RileyLeff/sapflux_sensor/releases/sap-flux-adapter-v0.1-layout-safety-2026-06-22/README.md

# Sap Flux Adapter v0.1 Layout Safety Copy

Created 2026-06-22 before hydrating the active KiCad layout for v0.2 input
protection work.

Files:

- `default.shipped-v0.1.kicad_pcb`: exact copy of the archived JLC-shipped
  PCB layout from `../sap-flux-adapter-v1.1-shipped-2026-03-21/default.kicad_pcb`.
  This is the canonical shipped board layout, despite the archive directory
  using the v1.1 release name; the board artwork itself is labeled v0.1.
- `default.active-pre-v0.2-hydration.kicad_pcb`: copy of
  `../../elec/layouts/default/default.kicad_pcb` immediately before replacing
  it with the Atopile-generated v0.2 layout.

Do not edit these files in place. Use them as recovery/reference artifacts.
