RileyLeff/sapflux_sensor/analysis/compression_research_20261024/fig_noise.png

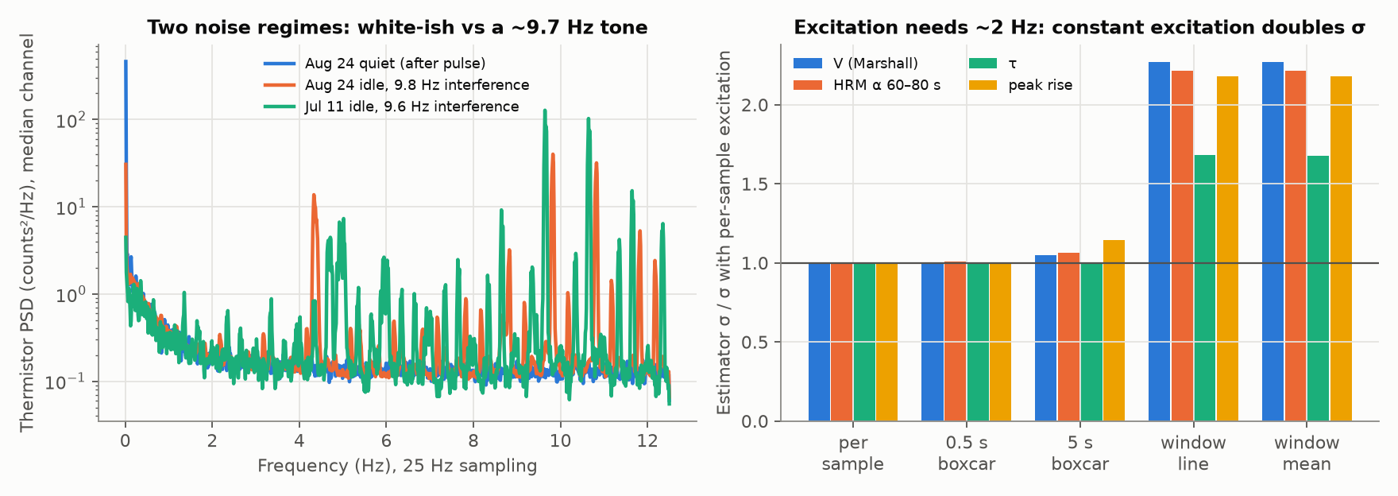
analysis/compression_research_20261024/fig_noise.png
