RileyLeff/sapflux_sensor/analysis/flow_vector_research_20261024/fig_fisher_angle.png

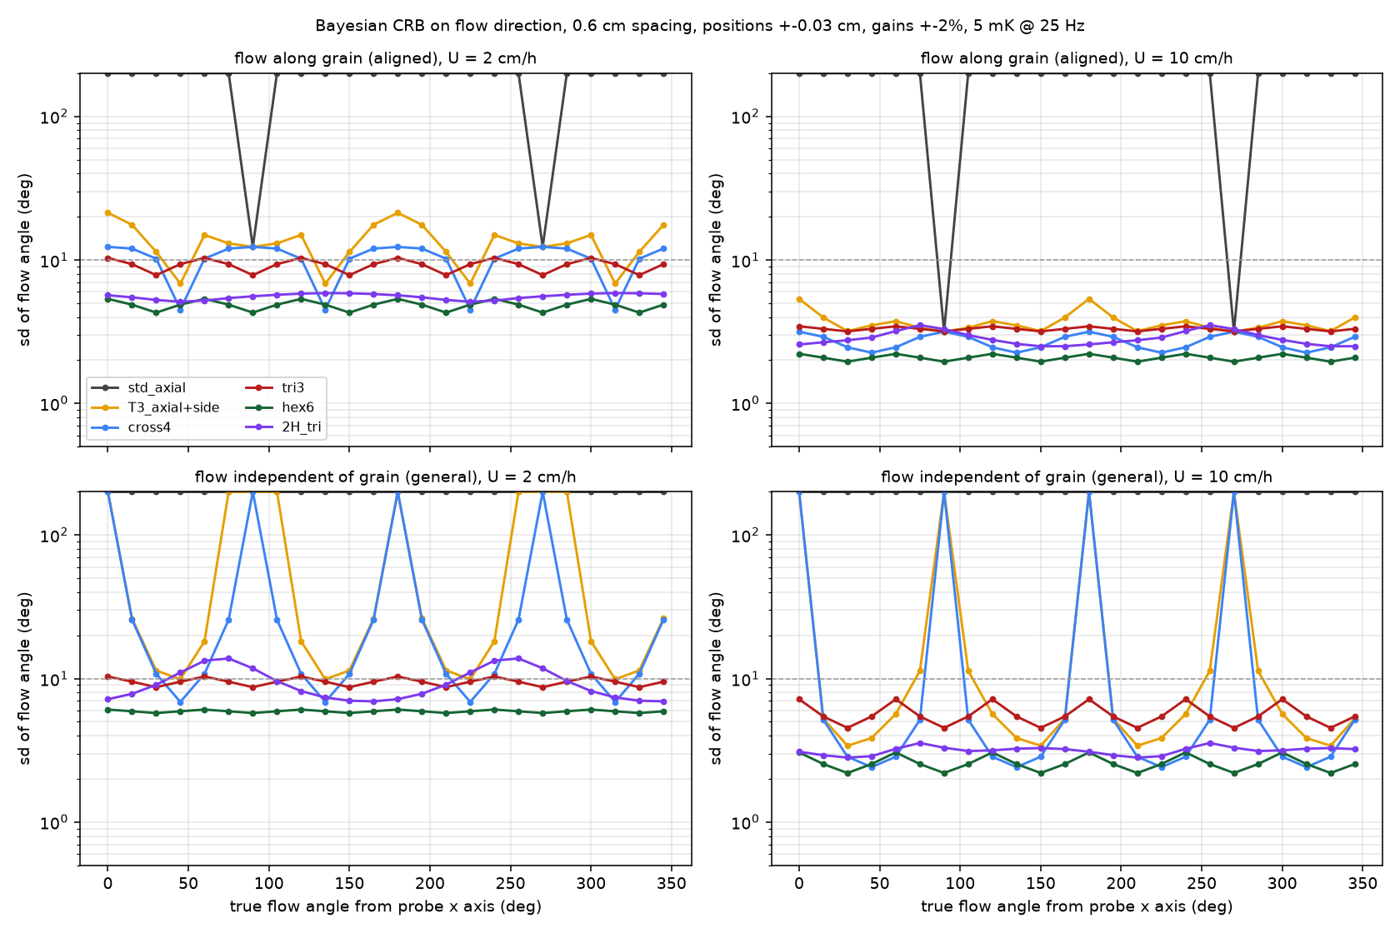
analysis/flow_vector_research_20261024/fig_fisher_angle.png
