RileyLeff/sapflux_sensor/analysis/flow_vector_research_20261024/fig_gain_vs_heater.png

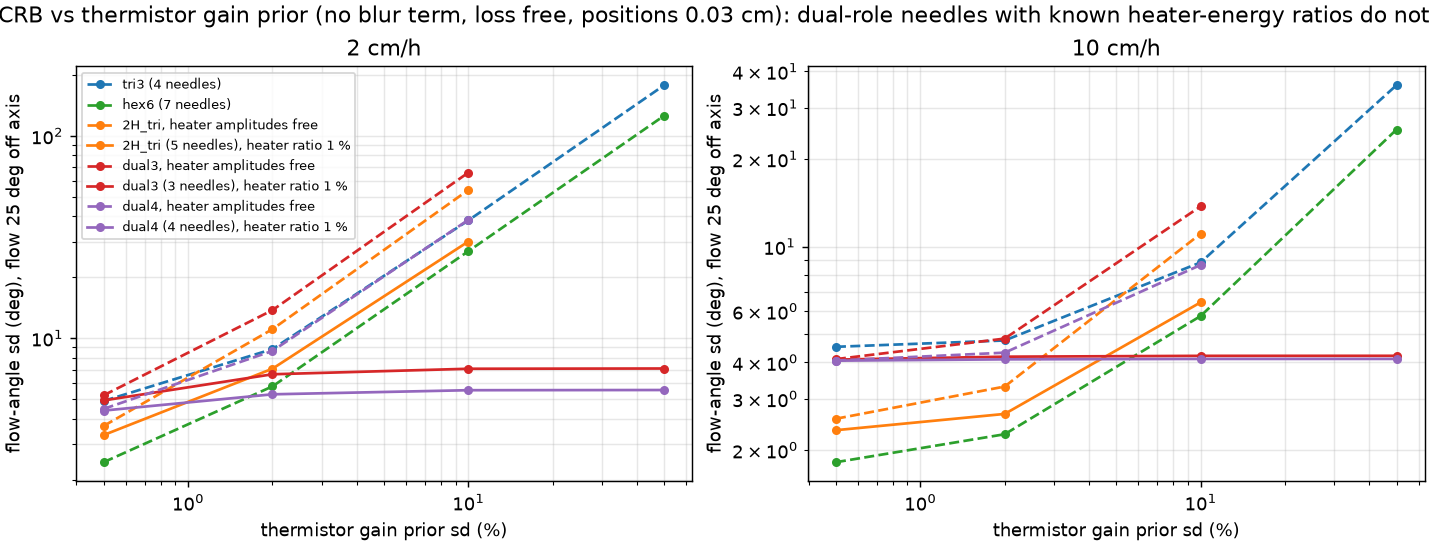
analysis/flow_vector_research_20261024/fig_gain_vs_heater.png
