RileyLeff/sapflux_sensor/analysis/flow_vector_research_20261024/fig_misalign_1d.png

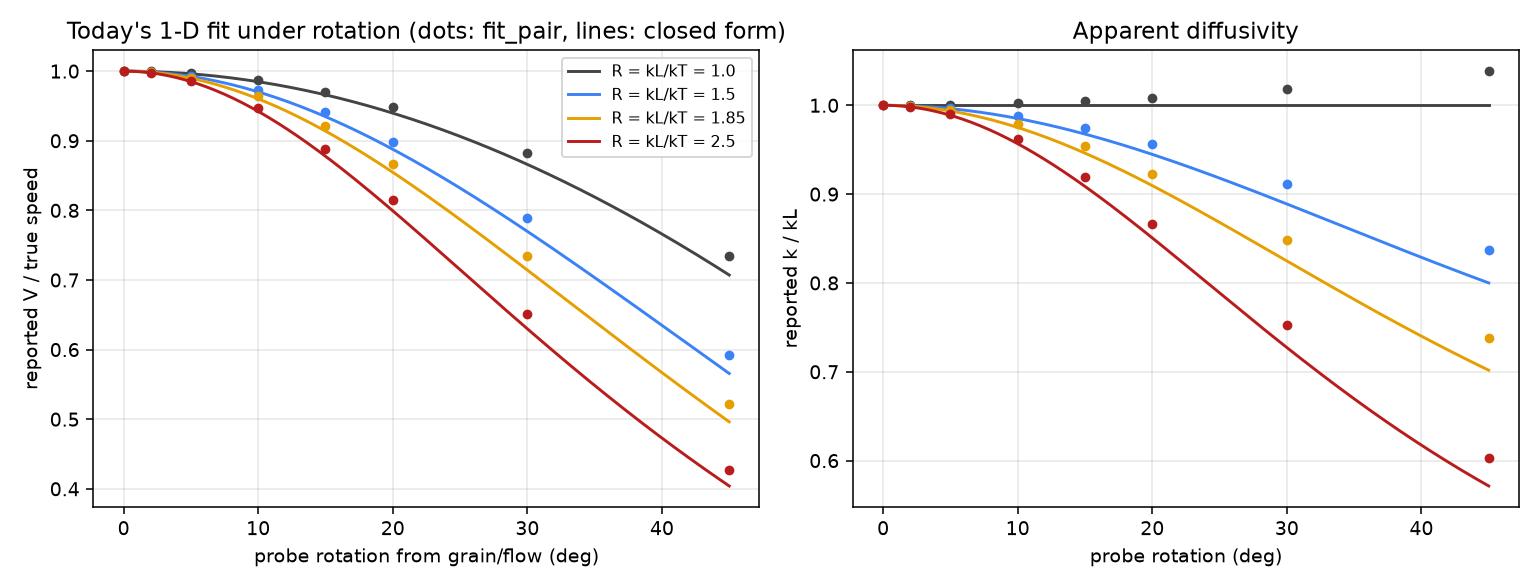
analysis/flow_vector_research_20261024/fig_misalign_1d.png
