RileyLeff/sapflux_sensor/analysis/flow_vector_research_20261024/fig_needle_flow.png

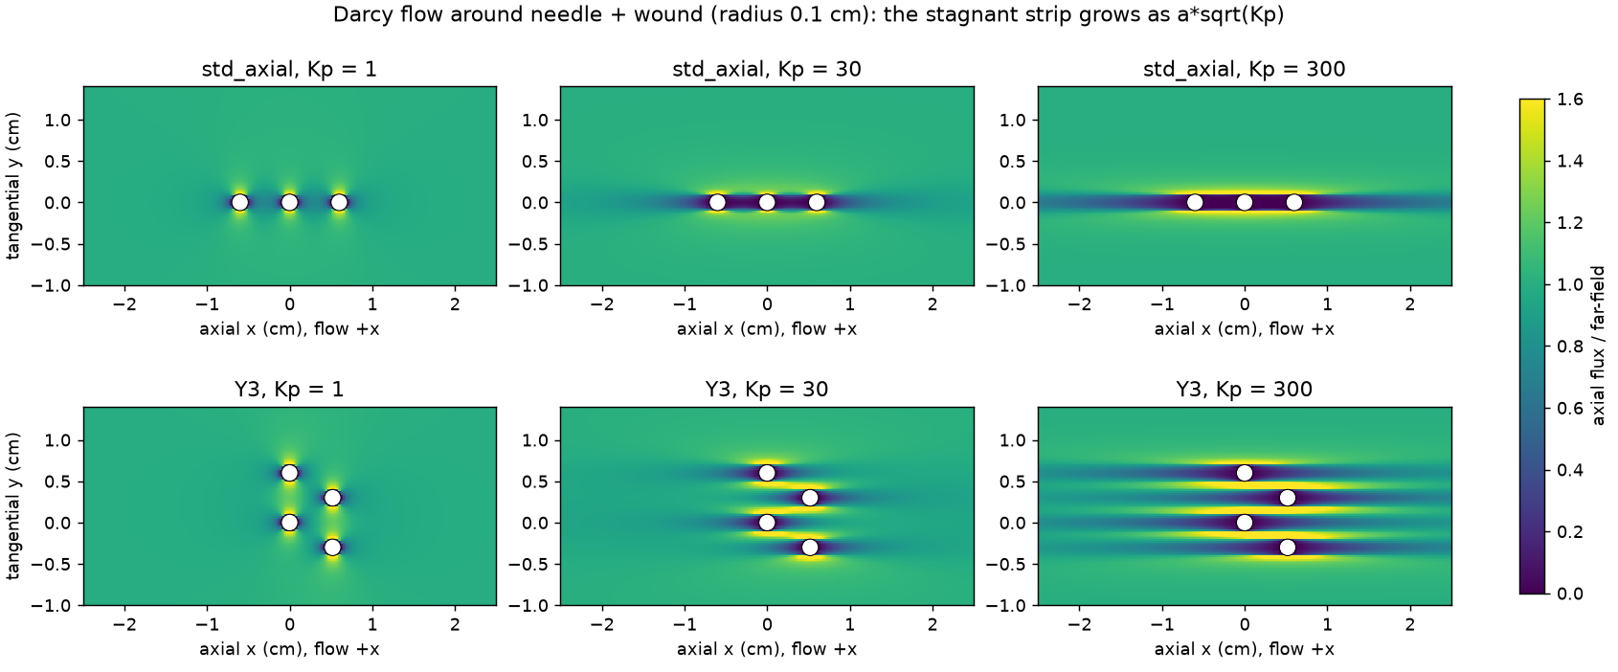
analysis/flow_vector_research_20261024/fig_needle_flow.png
