RileyLeff/sapflux_sensor/analysis/flow_vector_research_20261024/fig_needles_info.png

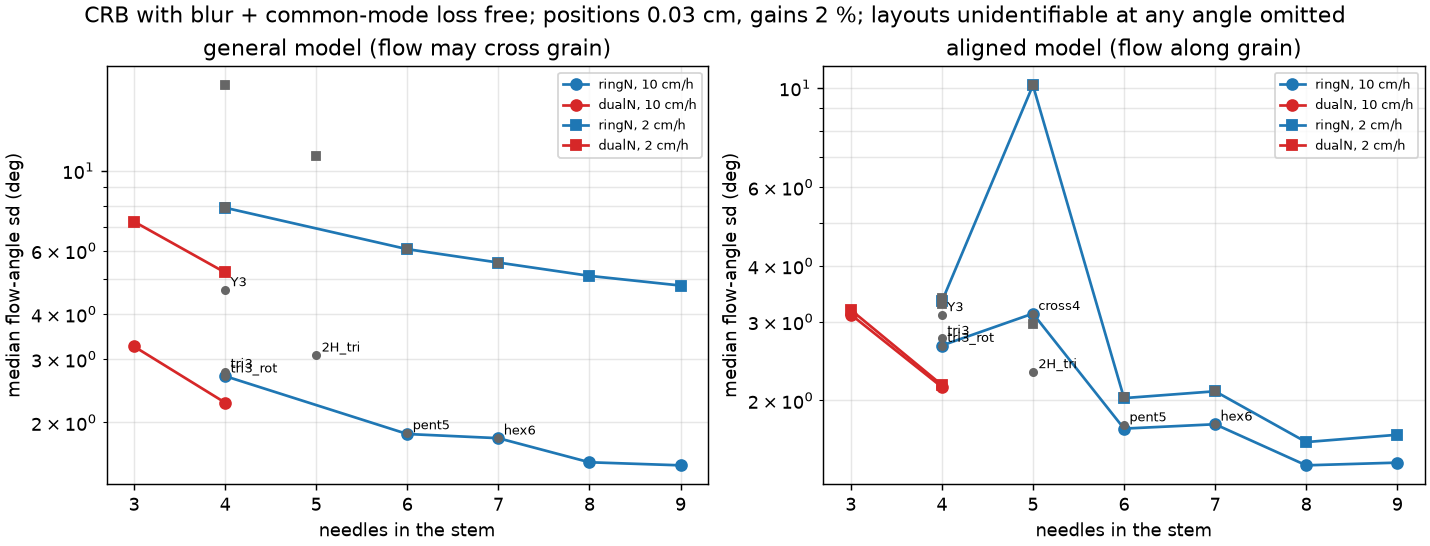
analysis/flow_vector_research_20261024/fig_needles_info.png
