RileyLeff/sapflux_sensor/analysis/needle_layout_20261025/fig_a_firstorder.png

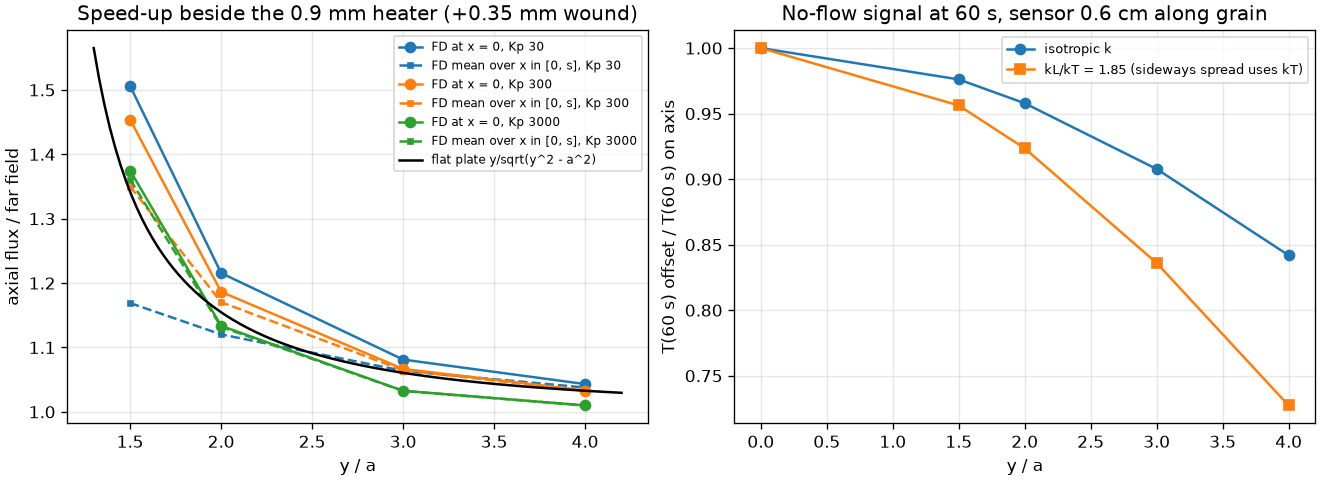
analysis/needle_layout_20261025/fig_a_firstorder.png
