RileyLeff/sapflux_sensor/analysis/needle_layout_20261025/fig_b_tolerance.png

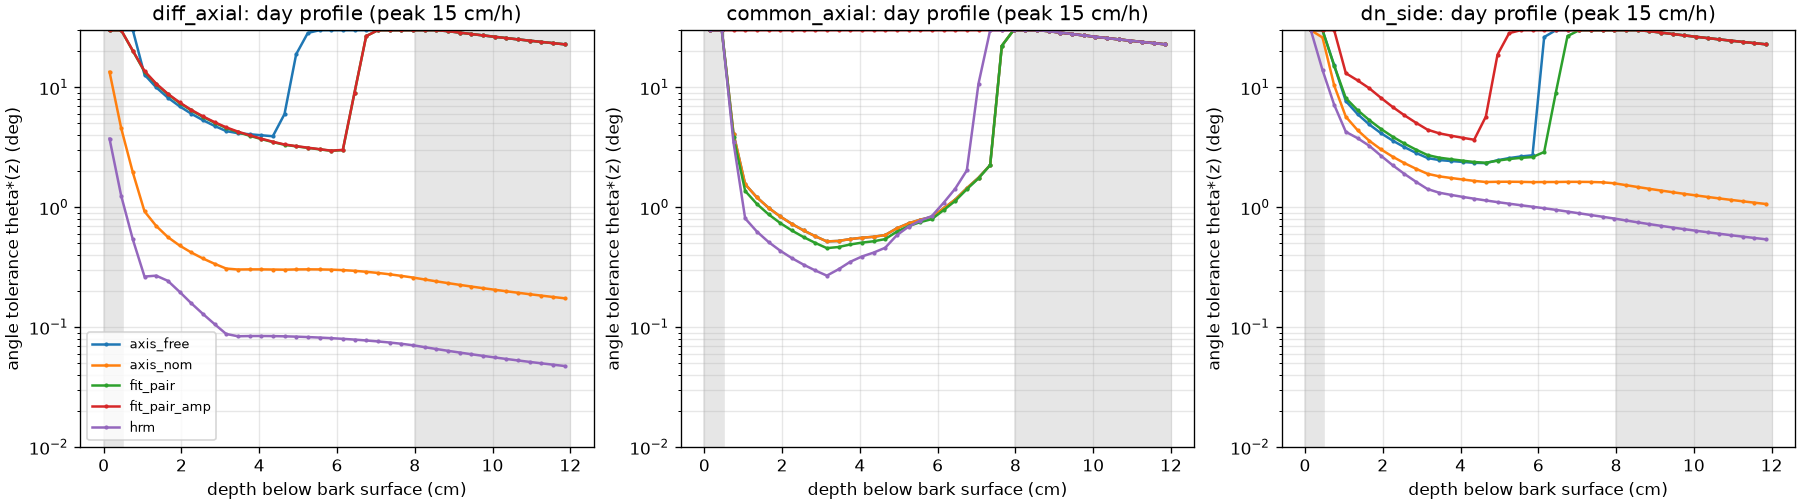
analysis/needle_layout_20261025/fig_b_tolerance.png
