RileyLeff/sapflux_sensor/analysis/outputs/4x4_pulse_20260824/4x4_pulse_model_fit.png

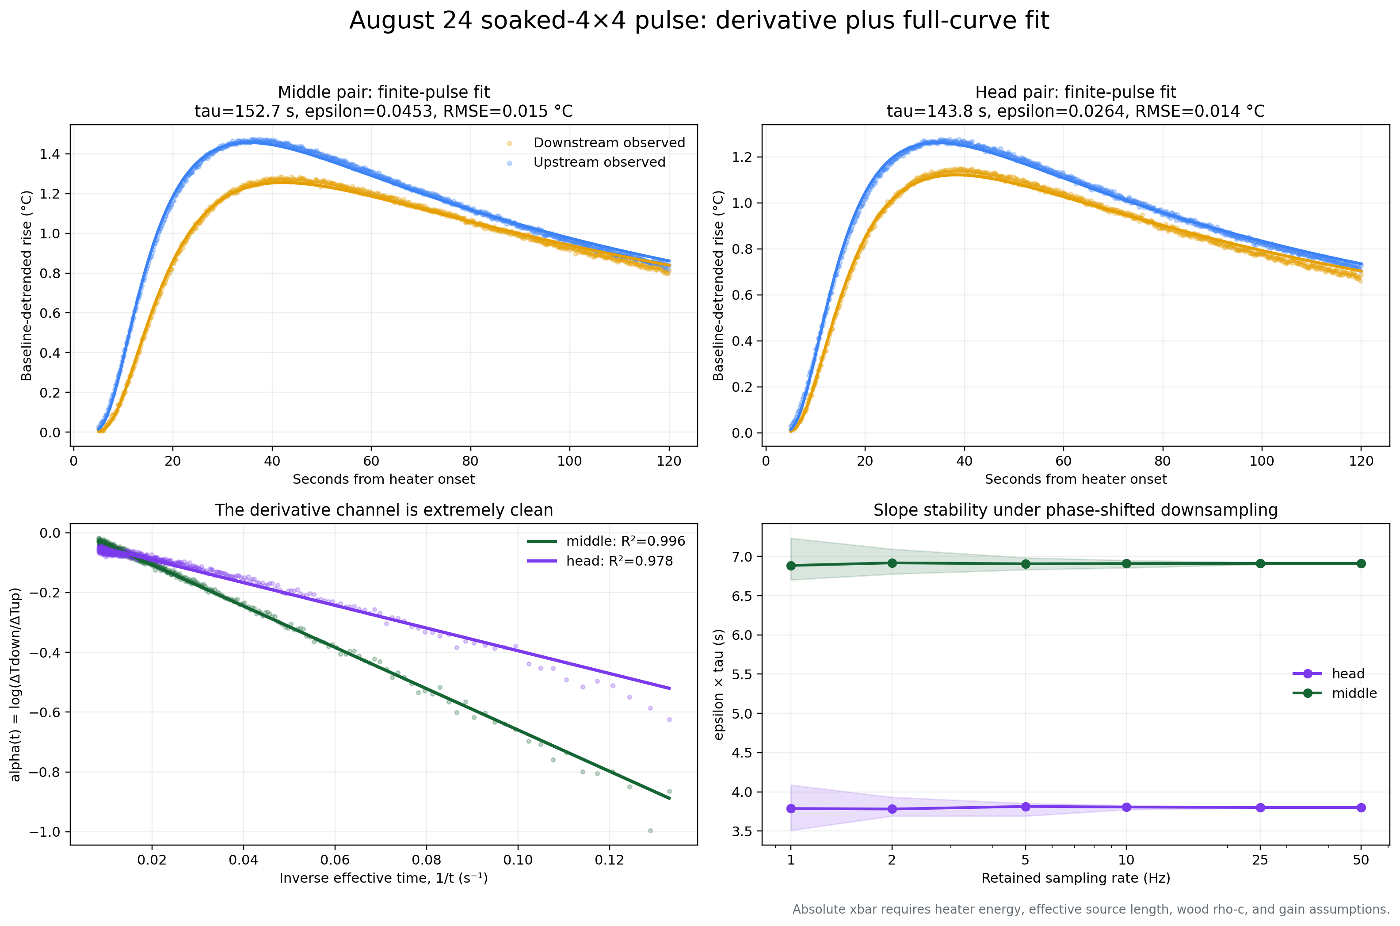
analysis/outputs/4x4_pulse_20260824/4x4_pulse_model_fit.png
