RileyLeff/sapflux_sensor/analysis/outputs/compression_20261024/pulse_representations.png

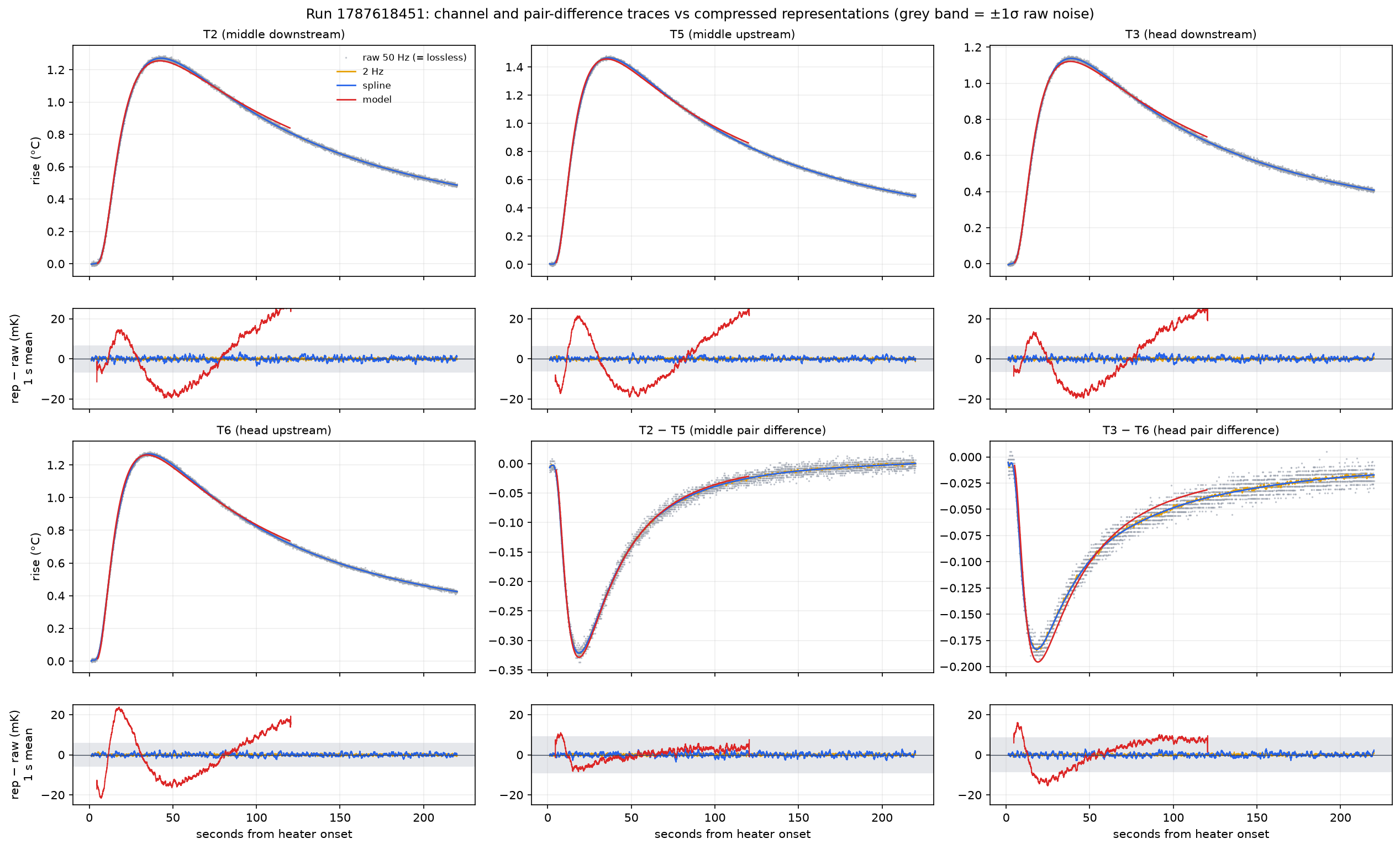
analysis/outputs/compression_20261024/pulse_representations.png
