RileyLeff/sapflux_sensor/assets/equidistant_sensor.jpg

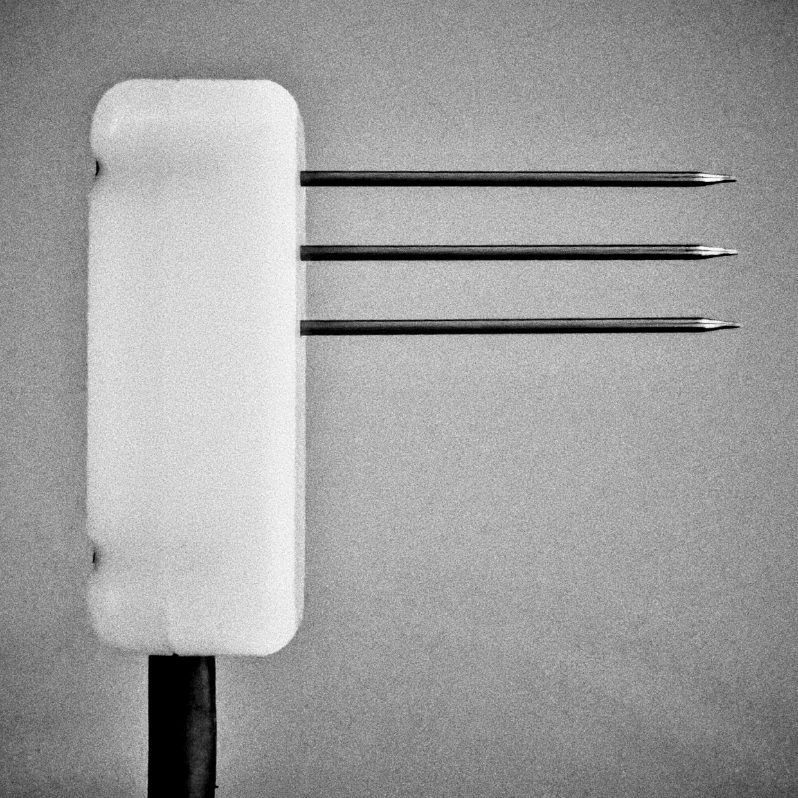
assets/equidistant_sensor.jpg
