RileyLeff/sapflux_sensor/assets/riley_style_sensor.jpg

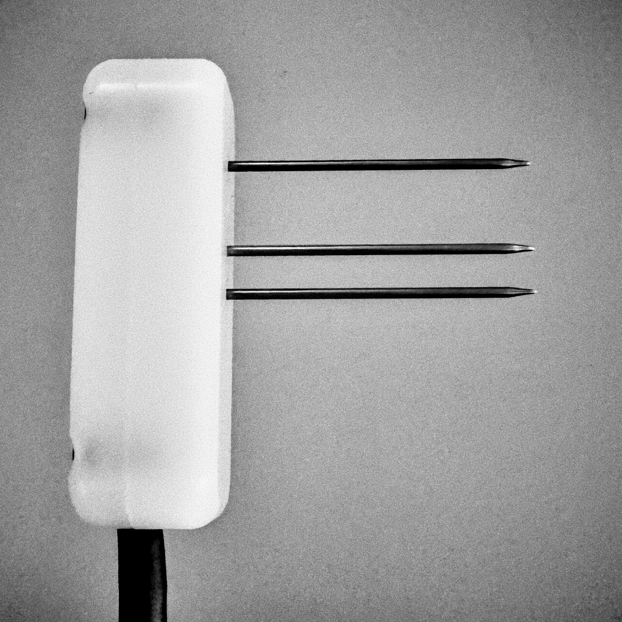
assets/riley_style_sensor.jpg
