RileyLeff/sapflux_sensor/claude_layout.png

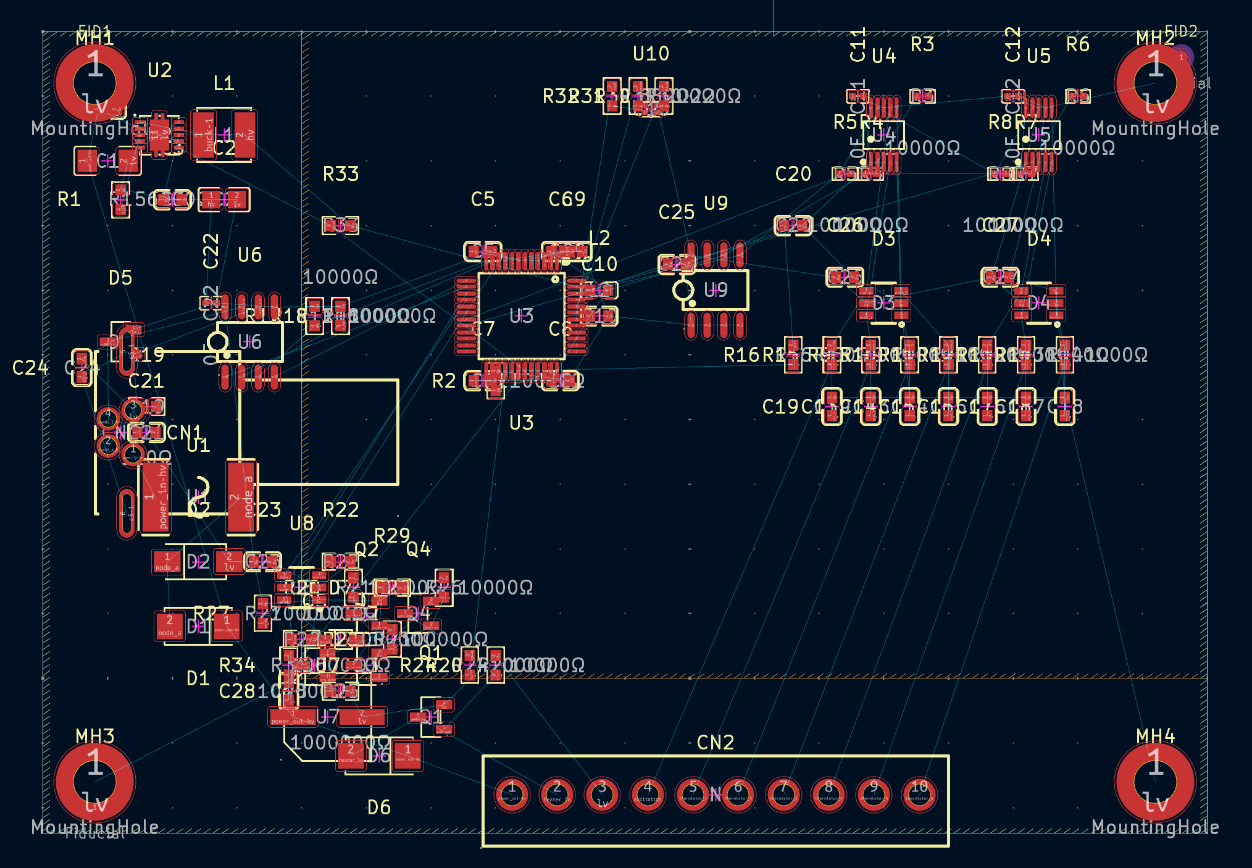
claude_layout.png
