RileyLeff/sapflux_sensor/crazy_screenshot.png

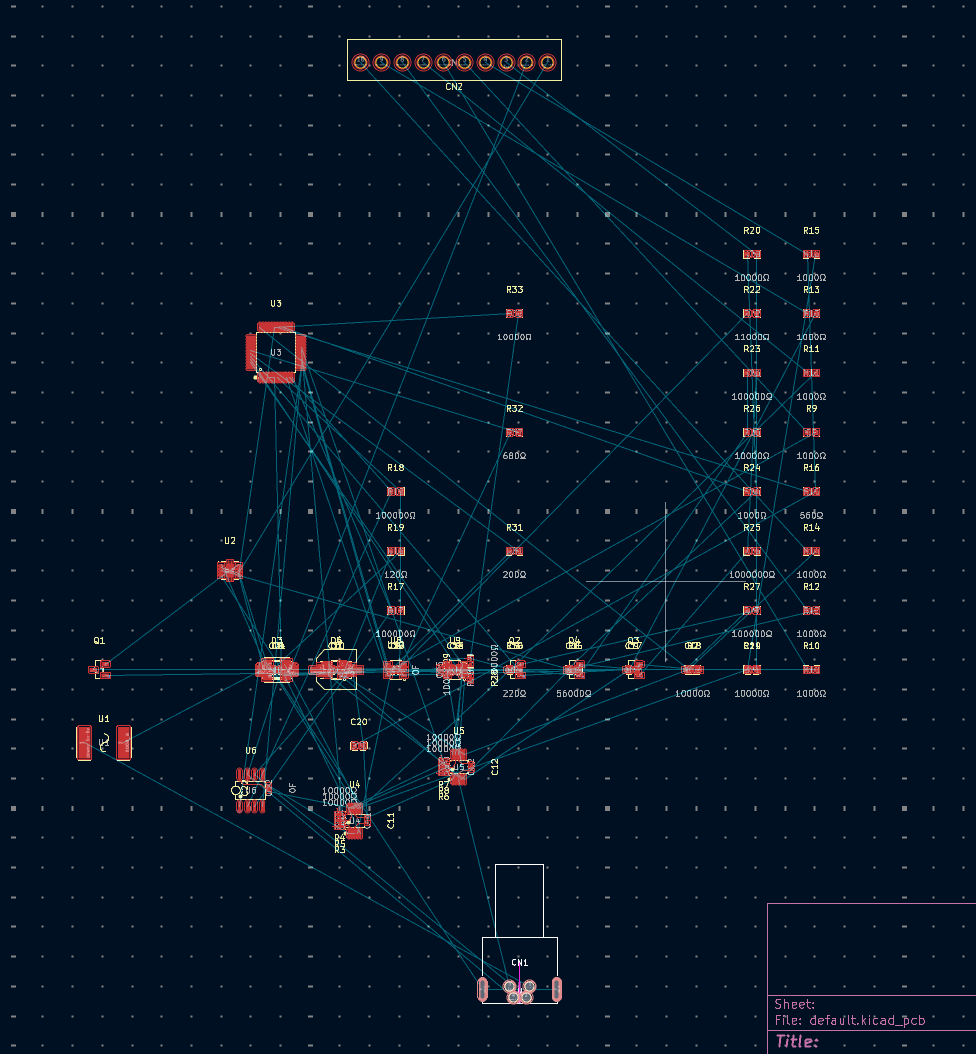
crazy_screenshot.png
