RileyLeff/sapflux_sensor/east30docs/IMG_0297.png

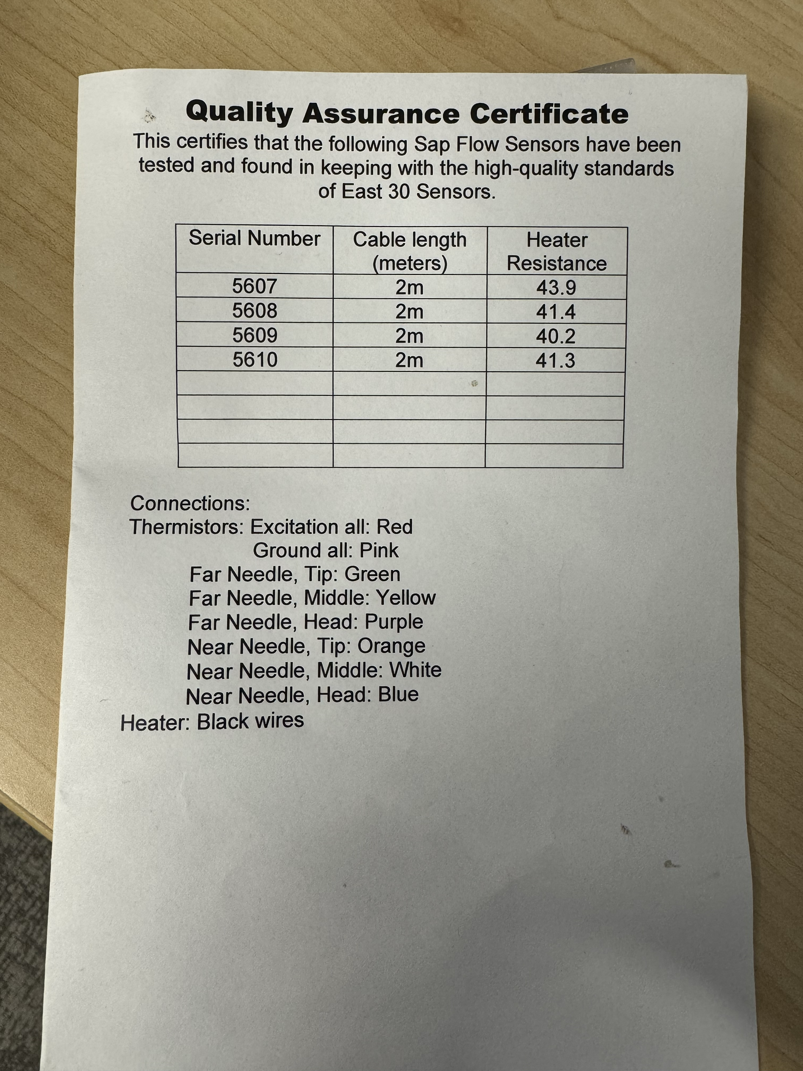
east30docs/IMG_0297.png
