RileyLeff/sapflux_sensor/mechanical/enclosure-mounts/asm.png

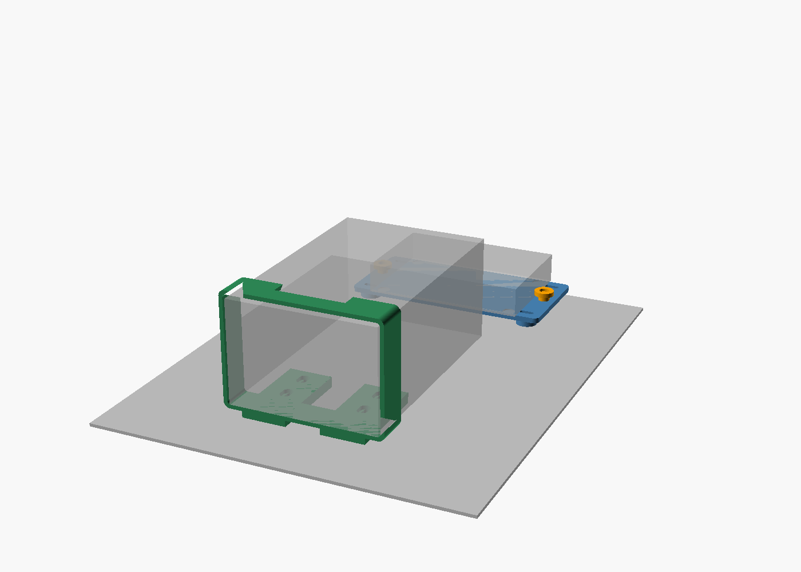
mechanical/enclosure-mounts/asm.png
