RileyLeff/sapflux_sensor/mechanical/enclosure-mounts/asm_plate.png

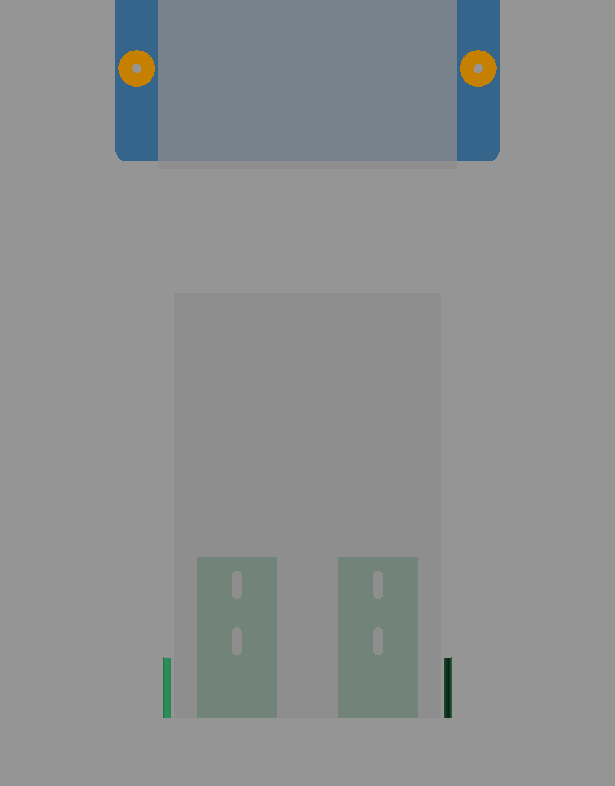
mechanical/enclosure-mounts/asm_plate.png
