RileyLeff/sapflux_sensor/mechanical/enclosure-mounts/tray_back.png

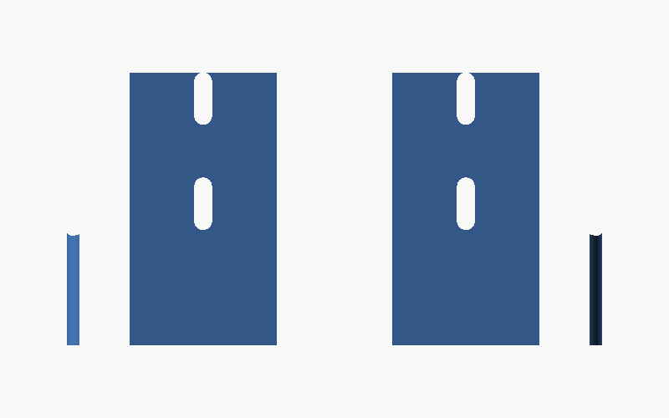
mechanical/enclosure-mounts/tray_back.png
