RileyLeff/sapflux_sensor/mechanical/enclosure-mounts/tray_iso.png

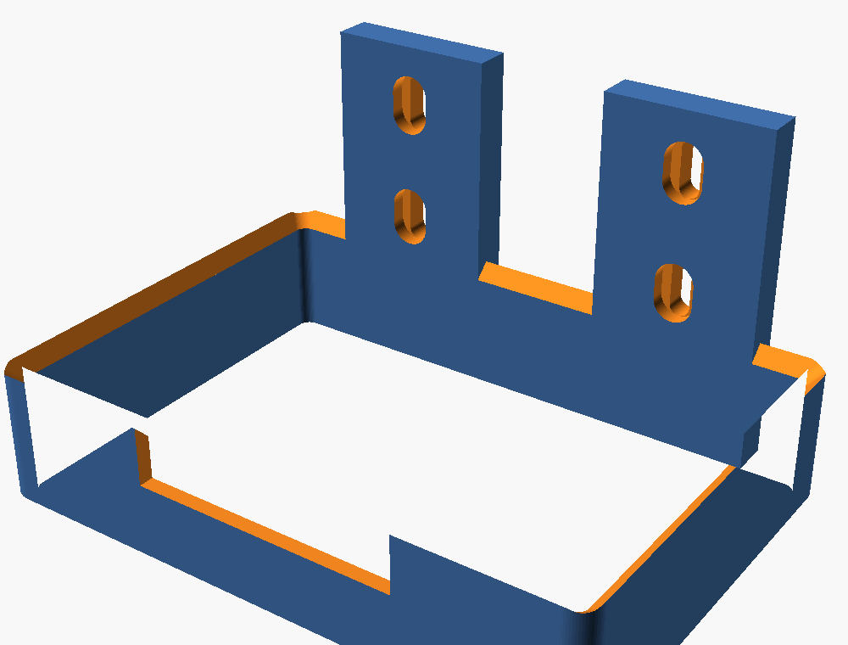
mechanical/enclosure-mounts/tray_iso.png
