RileyLeff/sapflux_sensor/screenshots/3d1.png

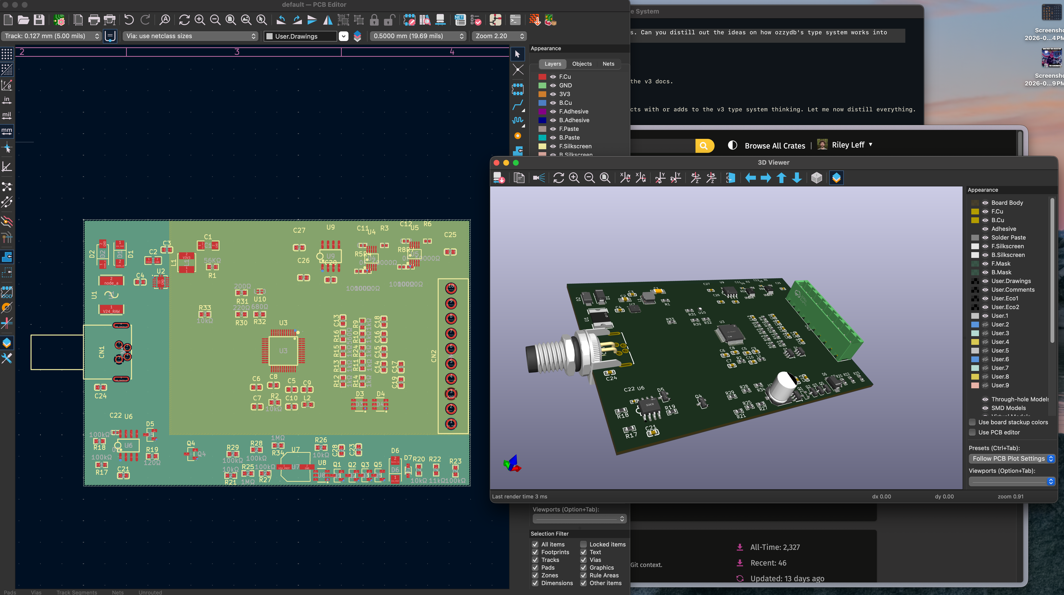
screenshots/3d1.png
