RileyLeff/sapflux_sensor/screenshots/footprint_overlap.png

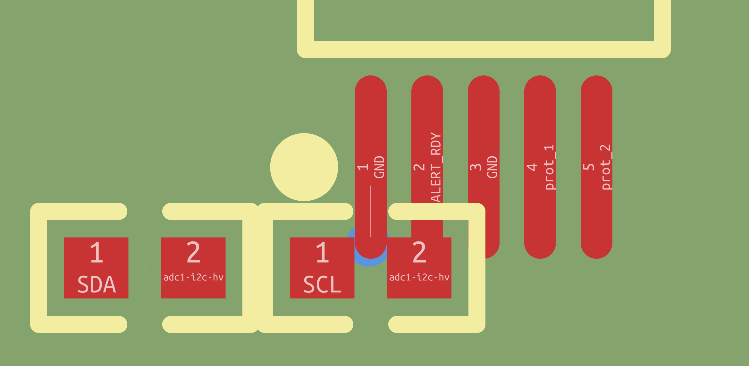
screenshots/footprint_overlap.png
