RileyLeff/sapflux_sensor/screenshots/layout_progress.png

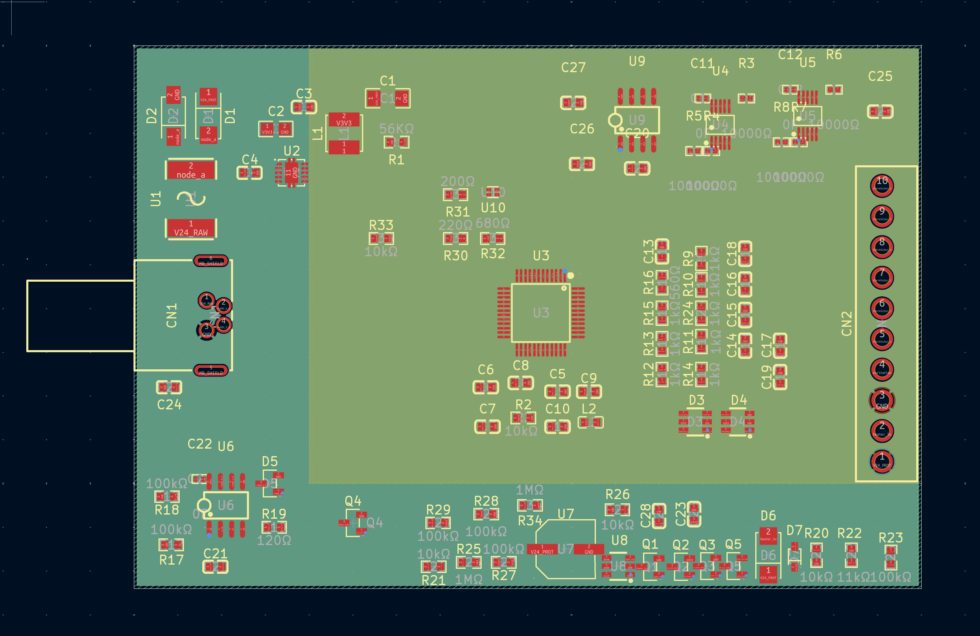
screenshots/layout_progress.png
