RileyLeff/sapflux_sensor/screenshots/mcu.png

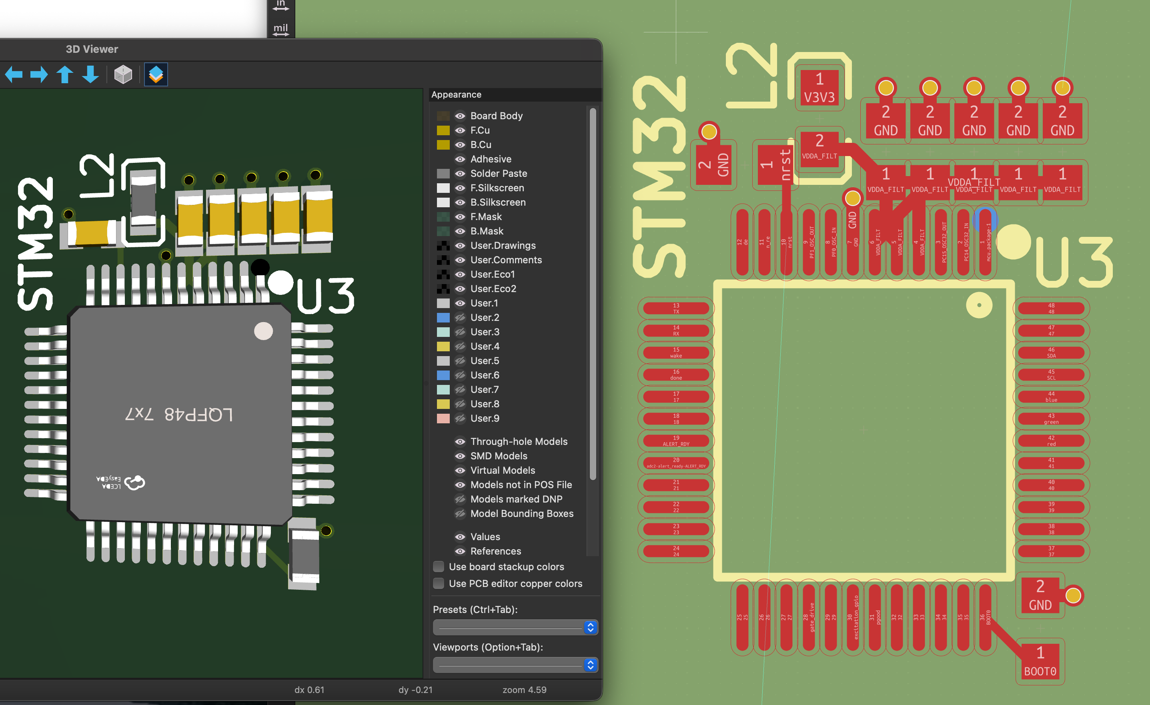
screenshots/mcu.png
