RileyLeff/sapflux_sensor/screenshots/overlap.png

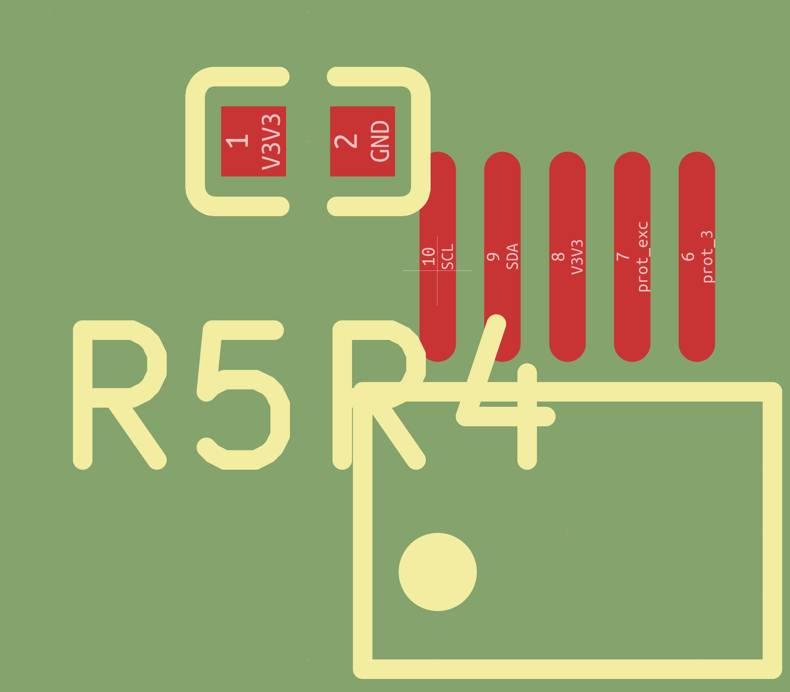
screenshots/overlap.png
