RileyLeff/sapflux_sensor/screenshots/riley1.png

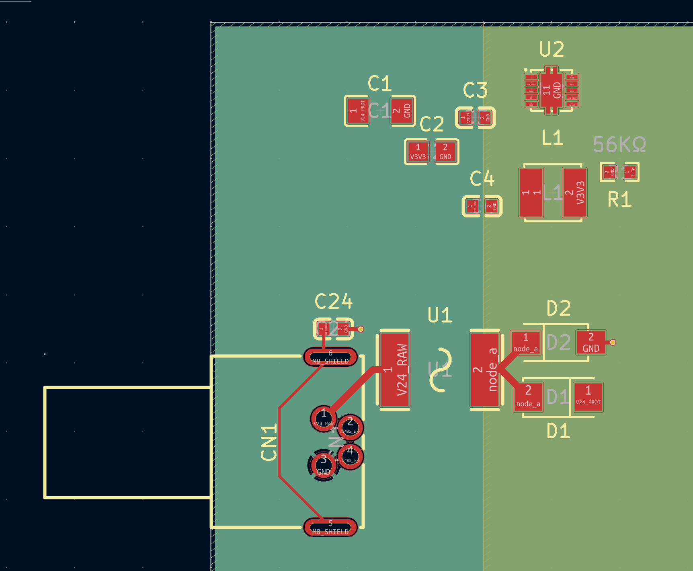
screenshots/riley1.png
