RileyLeff/sapflux_sensor/screenshots/rs485.png

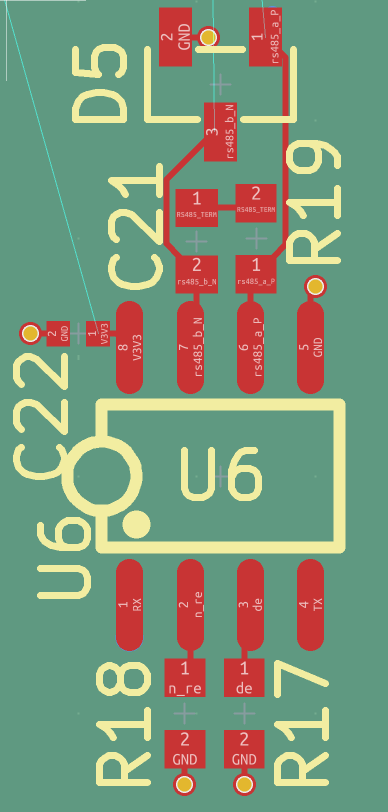
screenshots/rs485.png
