RileyLeff/sapflux_sensor/screenshots/weird_resistor.png

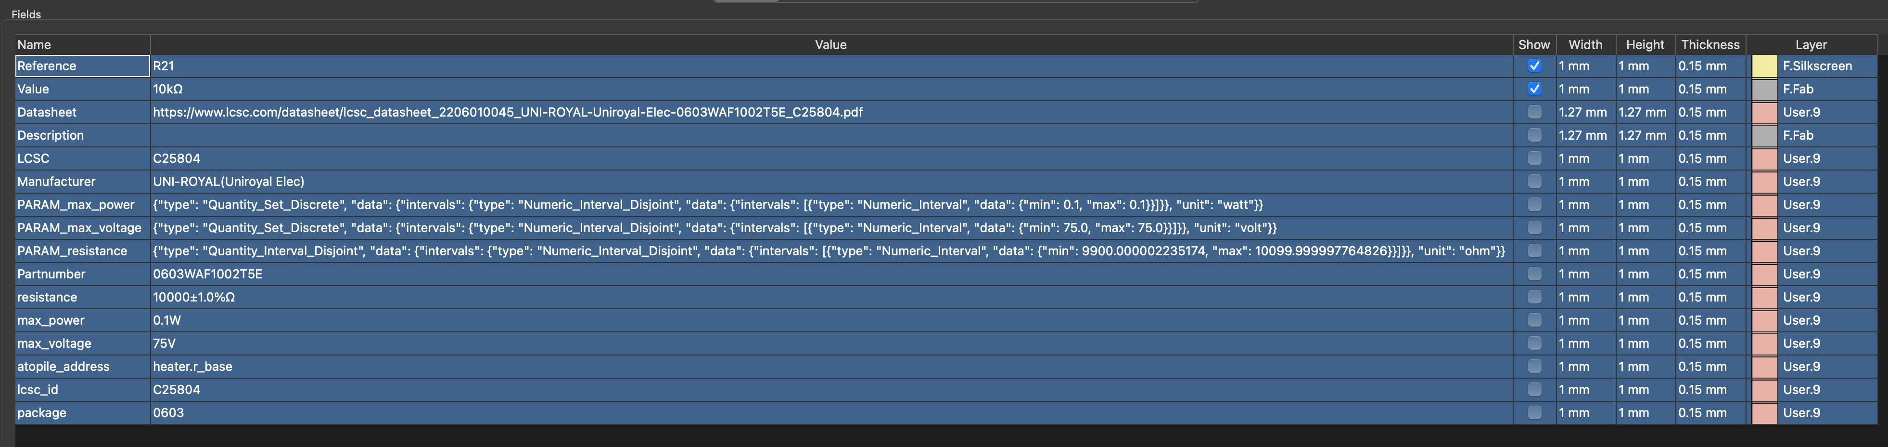
screenshots/weird_resistor.png
