RileyLeff/sapflux_sensor/screenshots/wire_close.png

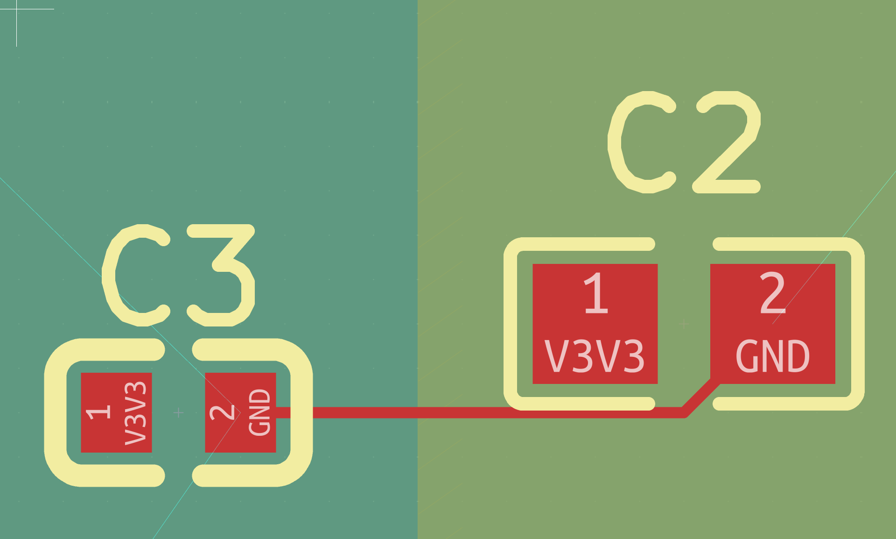
screenshots/wire_close.png
