RileyLeff/sapflux_sensor/gerber_export/default-bom.csv

Designator | Footprint | Quantity | Value | Manufacturer | Partnumber | LCSC Part #
BAT1 | Lian_Xin_Technology_BS_CR2032_8:BAT-SMD_BS-CR2032-8 | 1 |  | Lian Xin Technology | BS-CR2032-8 | C7498149
C1 | FH_1206B475K500NT:C1206 | 1 |  | FH | 1206B475K500NT | C29823
C2, C5, C6, C8, C9, C10, C12, C13, C14, C15, C16, C17, C18, C19, C21, C23, C24, C25, C26, C27, C29, C30, C31, C32, C33, C34, C35, C36, C37, C38, C39, C40, C41, C42, C43, C44, C45, C46, C47, C48, C49, C50, C51, C52, C53, C54, C55, C56, C57, C58, C59, C60, C61, C62, C63, C64, C65, C66, C67, C68, C69, C70, C71, C72, C73, C74, C75, C76, C77, C78, C79, C80, C81, C82, C83, C84, C85, C87 | YAGEO_CC0603KRX7R9BB104:C0603 | 78 |  | YAGEO | CC0603KRX7R9BB104 | C14663
C3 | TDK_C2012X5R1A226KT000N:C0805 | 1 |  | TDK | C2012X5R1A226KT000N | C76634
C4, C20, C28, C86, C88 | Samsung_Electro_Mechanics_CL10A105KB8NNNC:C0603 | 5 |  | Samsung Electro-Mechanics | CL10A105KB8NNNC | C15849
C11, C22 | Samsung_Electro_Mechanics_CL05B104KO5NNNC:C0402 | 2 | 0±10.0%F 16V X7R | Samsung Electro-Mechanics | CL05B104KO5NNNC | C1525
C89, C90 | FH_0402CG180J500NT:C0402 | 2 |  | FH | 0402CG180J500NT | C1549
CN1, J1 | Cixi_Kefa_Elec_KF2EDGV_3_5_2P:CONN-TH_P3.50_KF2EDGV-3.5-2P | 2 |  | Cixi Kefa Elec | KF2EDGV-3.5-2P | C441321
CN2 | XKB_Connectivity_X6521WV_2x30H_C60D30:HDR-TH_60P-P2.54-V-M-R2-C30-S2.54 | 1 |  | XKB Connectivity | X6521WV-2x30H-C60D30 | C2883964
D1, D3, D4, D8, D9, D10, D11, D12, D13, D14, D15, D16, D17 | TECH_PUBLIC_PRTR5V0U4D_TP:SOT-23-6_L2.9-W1.6-P0.95-LS2.8-BR | 13 |  | TECH PUBLIC | PRTR5V0U4D-TP | C2835429
D2 | FTR_SMAJ33A:SMA_L4.3-W2.6-LS5.0-RD | 1 |  | FTR | SMAJ33A | C693627
D5 | hongjiacheng_SM712:SOT-23-3_L2.9-W1.3-P1.90-LS2.4-BR | 1 |  | hongjiacheng | SM712 | C7420375
D6 | MDD_Microdiode_Electronics_SS36:SMA_L4.3-W2.6-LS5.2-RD | 1 |  | MDD（Microdiode Electronics） | SS36 | C16015
D7 | Changjiang_Electronics_Tech_1N4148WS:SOD-323_L1.8-W1.3-LS2.5-RD | 1 |  | Changjiang Electronics Tech | 1N4148WS | C2128
D18 | hongjiacheng_SS56:SMA_L4.3-W2.6-LS5.0-RD | 1 |  | hongjiacheng | SS56 | C18199169
D19 | hongjiacheng_MM3Z10:SOD-323_L1.7-W1.3-LS2.6-RD | 1 |  | hongjiacheng | MM3Z10 | C19077459
D20 | hongjiacheng_BAT54S:SOT-23-3_L2.9-W1.3-P1.90-LS2.4-BR | 1 |  | hongjiacheng | BAT54S | C7420333
F1, F2 | Xucheng_Elec_5x20:FUSE-TH_5X20RHOSFUSECLIP-SEAT | 2 |  | Xucheng Elec | 5x20 环保 保险管夹/座 | C3130
J2 | BOOMELE_2_54_1x6P:HDR-TH_6P-P2.54-V-M-1 | 1 |  | BOOMELE | 2.54-1x6P直针 | C37208
J3 | Cixi_Kefa_Elec_KF2EDGV_3_5_3P:CONN-TH_3P-P3.50_KF2EDGV-3.5-3P | 1 |  | Cixi Kefa Elec | KF2EDGV-3.5-3P | C441322
J4 | XFCN_PZ254V_11_04P:HDR-TH_4P-P2.54-V-M | 1 |  | XFCN | PZ254V-11-04P | C2691448
L1 | XR_XRNR4018_68uH_M:IND-SMD_L4.0-W4.0 | 1 |  | XR | XRNR4018-68uH/M | C5289353
L2, L3 | Sunlord_GZ1608D601TF:L0603 | 2 |  | Sunlord | GZ1608D601TF | C1002
Q1 | Tritech_MOS_TM15N10D:TO-252-2_L6.6-W6.2-P4.57-LS10.1-BR-CW | 1 |  | Tritech-MOS | TM15N10D | C7422818
Q2 | Changjiang_Electronics_Tech_SS8550_Y2_RANGE_200_350:SOT-23-3_L2.9-W1.3-P1.90-LS2.4-BR | 1 |  | Changjiang Electronics Tech | SS8550 Y2(RANGE:200-350) | C8542
Q3 | Changjiang_Electronics_Tech_MMBT3904_RANGE_100_300:SOT-23-3_L2.9-W1.3-P1.90-LS2.4-BR | 1 |  | Changjiang Electronics Tech | MMBT3904(RANGE:100-300) | C20526
Q4, Q5, Q6, Q7 | Changjiang_Electronics_Tech_2N7002:SOT-23-3_L2.9-W1.3-P1.90-LS2.4-BR | 4 |  | Changjiang Electronics Tech | 2N7002 | C8545
R1 | UNI_ROYAL_0603WAF5602T5E:R0603 | 1 | 56000±1.0%Ω 0.1W 75V | UNI-ROYAL(Uniroyal Elec) | 0603WAF5602T5E | C23206
R2, R21, R26, R33, R74, R75, R76, R79, R82, R85 | UNI_ROYAL_0603WAF1002T5E:R0603 | 10 | 10000±1.0%Ω 0.1W 75V | UNI-ROYAL(Uniroyal Elec) | 0603WAF1002T5E | C25804
R3, R4, R5 | UNI_ROYAL_0402WGF1002TCE:R0402 | 3 | 10000±1.0%Ω 0.062W 50V | UNI-ROYAL(Uniroyal Elec) | 0402WGF1002TCE | C25744
R6, R7, R8, R9, R10, R11, R12, R13, R14, R15, R20, R24, R35, R36, R37, R38, R39, R40, R41, R42, R43, R44, R45, R46, R47, R48, R49, R50, R51, R52, R53, R54, R55, R56, R57, R58, R59, R60, R61, R62, R63, R64, R65, R66, R67, R68, R69, R70, R71, R72, R73, R77, R78 | UNI_ROYAL_0603WAF1001T5E:R0603 | 53 | 1000±1.0%Ω 0.1W 75V | UNI-ROYAL(Uniroyal Elec) | 0603WAF1001T5E | C21190
R16 | FOJAN_FRC0603F2700TS:R0603 | 1 | 270±1.0%Ω 0.1W 75V | FOJAN | FRC0603F2700TS | C2907020
R17, R18, R23, R27, R28, R29, R81, R87 | UNI_ROYAL_0603WAF1003T5E:R0603 | 8 | 100000±1.0%Ω 0.1W 75V | UNI-ROYAL(Uniroyal Elec) | 0603WAF1003T5E | C25803
R19 | UNI_ROYAL_0603WAF1200T5E:R0603 | 1 | 120±1.0%Ω 0.1W 75V | UNI-ROYAL(Uniroyal Elec) | 0603WAF1200T5E | C22787
R22 | UNI_ROYAL_0603WAF1102T5E:R0603 | 1 | 11000±1.0%Ω 0.1W 75V | UNI-ROYAL(Uniroyal Elec) | 0603WAF1102T5E | C25950
R25, R34, R83, R84, R86 | UNI_ROYAL_0603WAF1004T5E:R0603 | 5 | 1000000±1.0%Ω 0.1W 75V | UNI-ROYAL(Uniroyal Elec) | 0603WAF1004T5E | C22935
R30 | UNI_ROYAL_0603WAF2200T5E:R0603 | 1 | 220±1.0%Ω 0.1W 75V | UNI-ROYAL(Uniroyal Elec) | 0603WAF2200T5E | C22962
R31 | UNI_ROYAL_0603WAF2000T5E:R0603 | 1 | 200±1.0%Ω 0.1W 75V | UNI-ROYAL(Uniroyal Elec) | 0603WAF2000T5E | C8218
R32 | UNI_ROYAL_0603WAF6800T5E:R0603 | 1 | 680±1.0%Ω 0.1W 75V | UNI-ROYAL(Uniroyal Elec) | 0603WAF6800T5E | C23228
R80 | UNI_ROYAL_0603WAF4704T5E:R0603 | 1 |  | UNI-ROYAL | 0603WAF4704T5E | C23163
U1, U5, U11 | Nexperia_74HC4067PW_118:TSSOP-24_L7.8-W4.4-P0.65-LS6.4-BL | 3 |  | Nexperia | 74HC4067PW,118 | C179326
U2 | Texas_Instruments_LM5165YDRCR:VSON-10_L3.0-W3.0-P0.50-TL-EP | 1 |  | Texas Instruments | LM5165YDRCR | C2071924
U3 | STMicroelectronics_STM32G0B1CBT6:LQFP-48_L7.0-W7.0-P0.50-LS9.0-BL | 1 |  | STMicroelectronics | STM32G0B1CBT6 | C2847904
U4 | Texas_Instruments_ADS1115IDGSR:MSOP-10_L3.0-W3.0-P0.50-LS5.0-BL | 1 |  | Texas Instruments | ADS1115IDGSR | C37593
U6 | MaxLinear_SP3485EN_L_TR:SOIC-8_L5.0-W4.0-P1.27-LS6.0-BL | 1 |  | MaxLinear | SP3485EN-L/TR | C8963
U7 | Littelfuse_2920L110_60MR:F2920 | 1 |  | Littelfuse | 2920L110/60MR | C315903
U8 | Texas_Instruments_TPL5010DDCR:SOT-23-6_L2.9-W1.6-P0.95-LS2.8-BR | 1 |  | Texas Instruments | TPL5010DDCR | C473912
U9 | onsemi_CAT24C32WI_GT3:SOIC-8_L5.0-W4.0-P1.27-LS6.0-BL | 1 |  | onsemi | CAT24C32WI-GT3 | C81193
U10 | XINGLIGHT_XL_B1212RGBA_HF:LED-SMD_4P-L1.2-W1.2_BR | 1 |  | XINGLIGHT | XL-B1212RGBA-HF | C22461780
U12 | Honor_Elec_VP1H101M0607:CAP-SMD_BD6.3-L6.6-W6.6-LS7.2-FD | 1 |  | Honor Elec | VP1H101M0607 | C4054386
U13 | Winbond_Elec_W25Q256JVFIQ:SOIC-16_L10.3-W7.5-P1.27-LS10.3-BL | 1 |  | Winbond Elec | W25Q256JVFIQ | C779876
Y1 | Seiko_Epson_Q13FC13500004:FC-135R_L3.2-W1.5 | 1 |  | Seiko Epson | Q13FC13500004 | C32346
