RileyLeff/sapflux_sensor/common_lib/3d_models/CONN-TH_10P-P3.50_KF2EDGV-3.5-10P.step

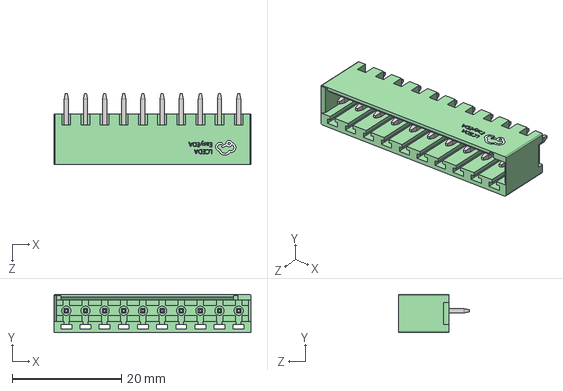
[picture p41: CAD file, 2026-02-19]
common_lib/3d_models/CONN-TH_10P-P3.50_KF2EDGV-3.5-10P.step
36.0 x 7.00 x 12.9 mm
