RileyLeff/sapflux_sensor/elec/parts/CAZN_M8_P4A_GPL_M8_JD/CONN-TH_M8-P4A-GPL-M8-JD.STEP

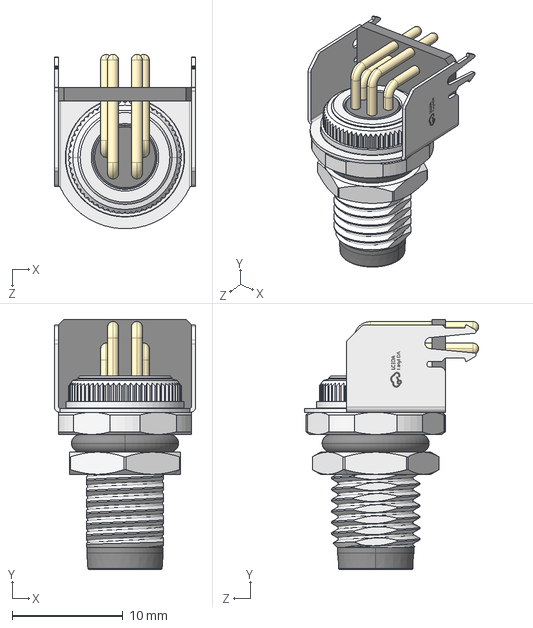
[picture p42: CAD file, 2026-02-19]
elec/parts/CAZN_M8_P4A_GPL_M8_JD/CONN-TH_M8-P4A-GPL-M8-JD.STEP
12.8 x 22.6 x 15.7 mm
