RileyLeff/sapflux_sensor/elec/parts/Cixi_Kefa_Elec_KF2EDGV_3_5_2P/CONN-TH_P3.50_KF2EDGV-3.5-2P.step

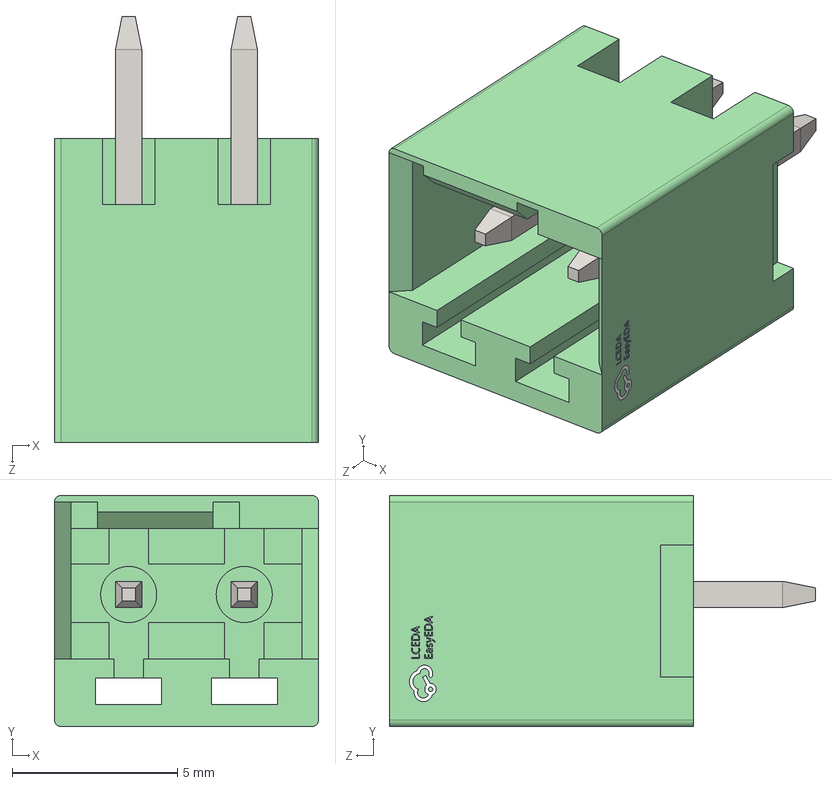
[picture p43: CAD file, 2026-03-03]
elec/parts/Cixi_Kefa_Elec_KF2EDGV_3_5_2P/CONN-TH_P3.50_KF2EDGV-3.5-2P.step
8.00 x 7.00 x 12.9 mm
