RileyLeff/sapflux_sensor/elec/parts/Cixi_Kefa_Elec_KF2EDGV_3_5_3P/15EDGVC-3.5-03P-14-00A(H).STEP

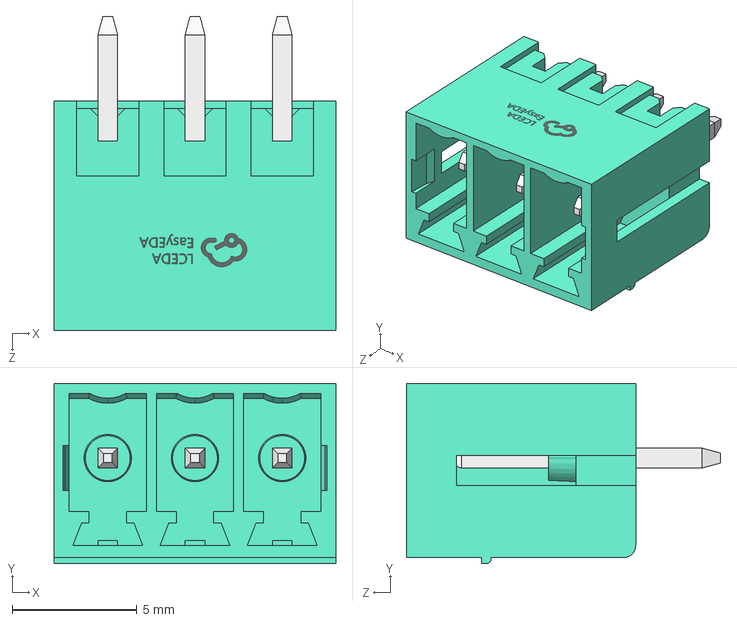
[picture p44: CAD file, 2026-03-05]
elec/parts/Cixi_Kefa_Elec_KF2EDGV_3_5_3P/15EDGVC-3.5-03P-14-00A(H).STEP
11.3 x 7.24 x 12.6 mm
