RileyLeff/sapflux_sensor/elec/parts/HUASHUO_HSU0195A/TO-252-2_L6.5-W5.6-P4.60-LS9.7-BR.step

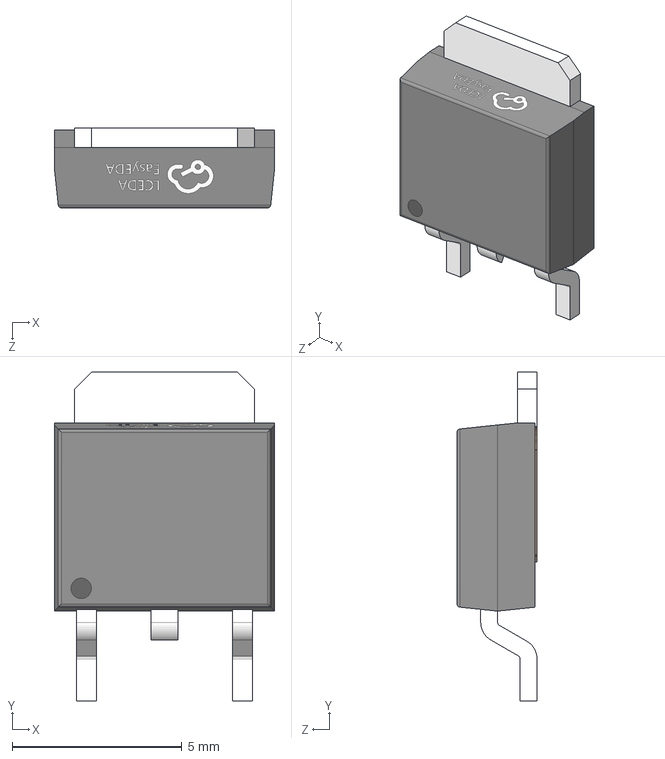
[picture p45: CAD file, 2026-06-24]
elec/parts/HUASHUO_HSU0195A/TO-252-2_L6.5-W5.6-P4.60-LS9.7-BR.step
6.50 x 9.70 x 2.36 mm
