RileyLeff/sapflux_sensor/elec/parts/Tritech_MOS_TM15N10D/TO-252-2_L6.6-W6.2-P4.57-LS10.1-BR-CW.step

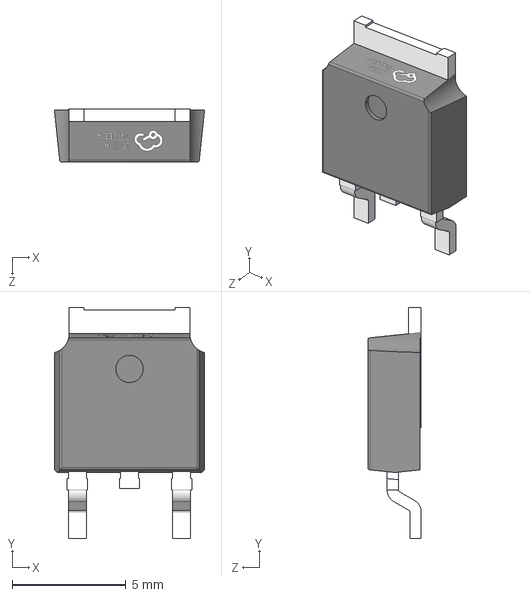
[picture p46: CAD file, 2026-03-03]
elec/parts/Tritech_MOS_TM15N10D/TO-252-2_L6.6-W6.2-P4.57-LS10.1-BR-CW.step
6.60 x 10.1 x 2.35 mm
