RileyLeff/sapflux_sensor/elec/parts/XINGLIGHT_XL_B1212RGBA_HF/LED-SMD_4P-L1.2-W1.2_BR.STEP

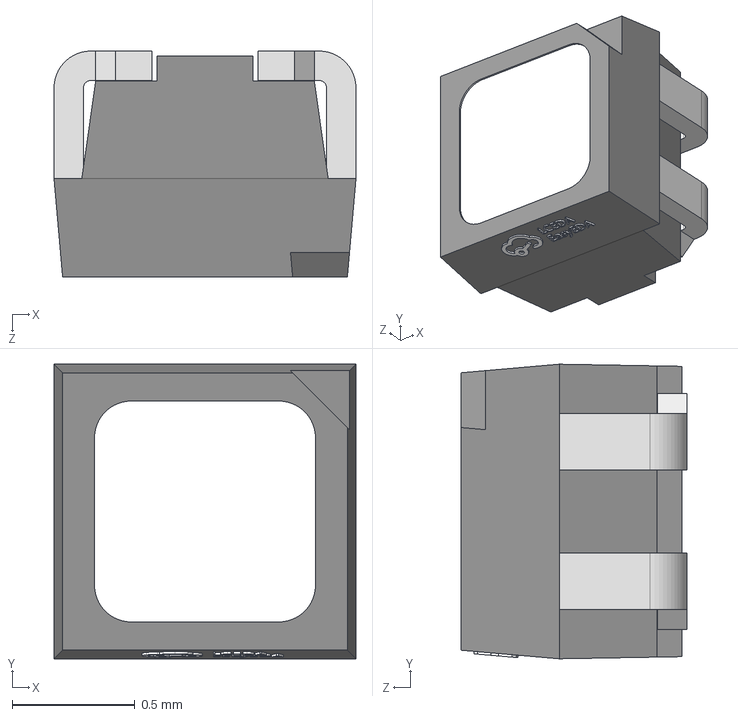
[picture p47: CAD file, 2026-02-19]
elec/parts/XINGLIGHT_XL_B1212RGBA_HF/LED-SMD_4P-L1.2-W1.2_BR.STEP
1.23 x 1.20 x 0.92 mm
