RileyLeff/sapflux_sensor/elec/parts/XKB_Connectivity_X6521WV_2x30H_C60D30/HDR-TH_60P-P2.54-V-M-R2-C30-S2.54.STEP

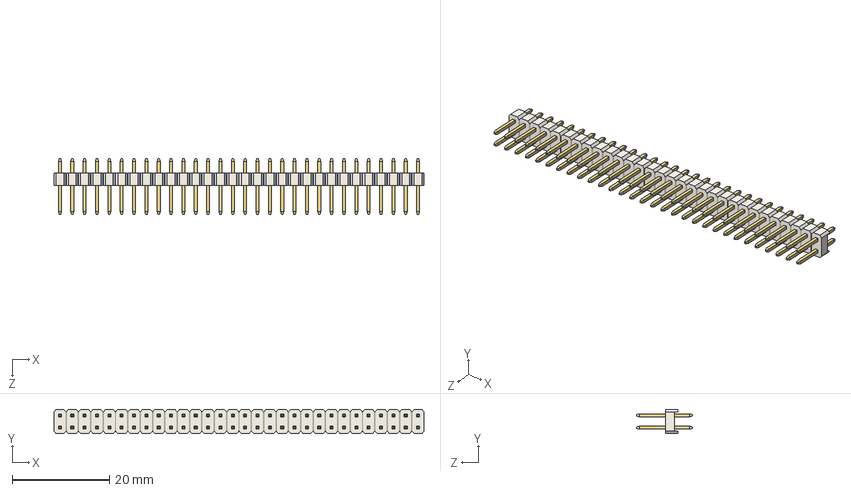
[picture p48: CAD file, 2026-03-03]
elec/parts/XKB_Connectivity_X6521WV_2x30H_C60D30/HDR-TH_60P-P2.54-V-M-R2-C30-S2.54.STEP
76.1 x 5.00 x 11.5 mm
