RileyLeff/sapflux_sensor/mechanical/drill-guides/riley-10mm-5mm-bit-54.stl

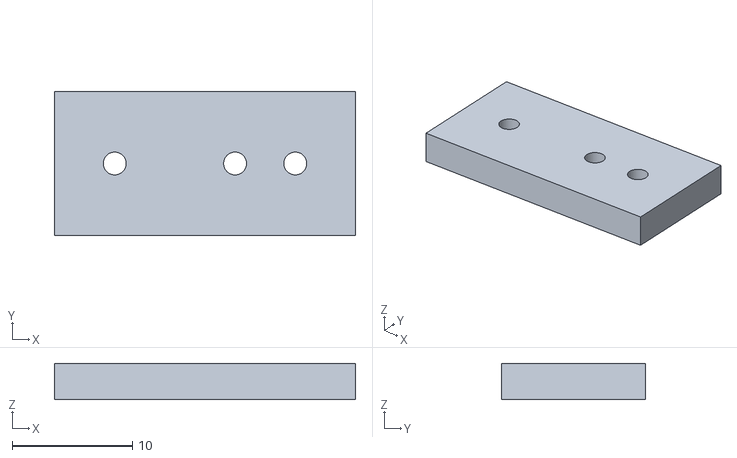
[picture p49: CAD file, 2026-10-24]
mechanical/drill-guides/riley-10mm-5mm-bit-54.stl
25.0 x 12.0 x 3.00
