RileyLeff/sapflux_sensor/mechanical/enclosure-mounts/battery_tray.stl

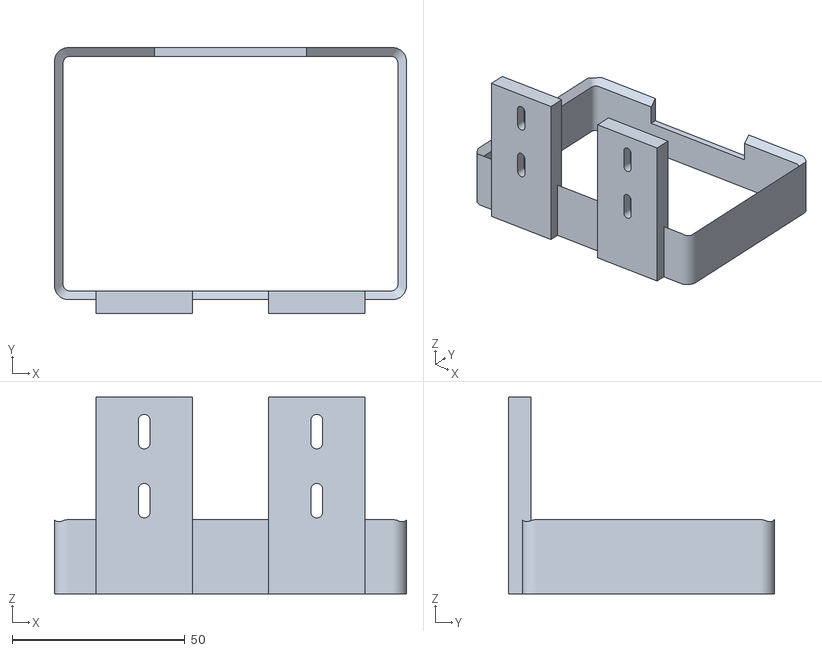
[picture p50: CAD file, 2026-08-24]
mechanical/enclosure-mounts/battery_tray.stl
102.0 x 77.0 x 57.0
