RileyLeff/sapflux_sensor/common_lib/3d_models/SMA_L4.5-W2.6-LS5.1-RD.step

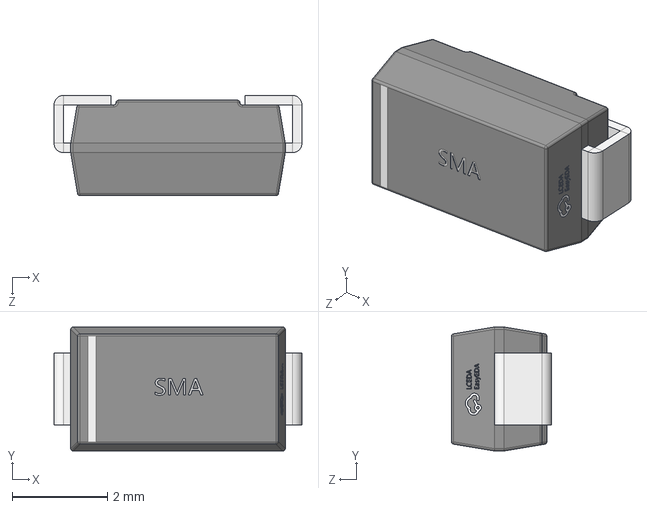
[picture p51: CAD file, 2026-02-19]
common_lib/3d_models/SMA_L4.5-W2.6-LS5.1-RD.step
5.20 x 2.60 x 2.10 mm
