RileyLeff/sapflux_sensor/mechanical/drill-guides/equidistant-6mm-bit-55.stl

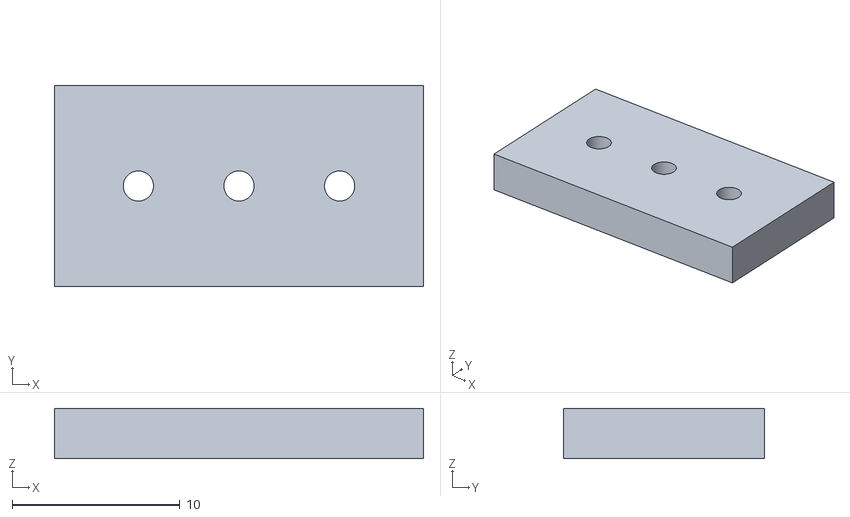
[picture p52: CAD file, 2026-10-24]
mechanical/drill-guides/equidistant-6mm-bit-55.stl
22.0 x 12.0 x 3.00
