RileyLeff/sapflux_sensor/mechanical/enclosure-mounts/back_bracket.stl

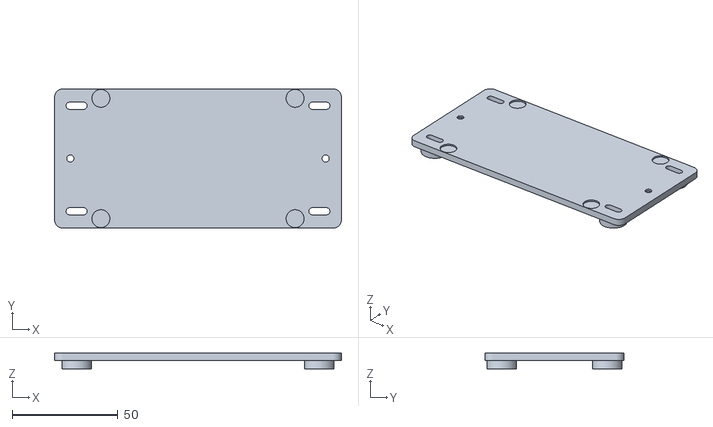
[picture p53: CAD file, 2026-08-24]
mechanical/enclosure-mounts/back_bracket.stl
136.0 x 66.0 x 7.50
