RileyLeff/sapflux_sensor/mechanical/enclosure-mounts/peg_cap.stl

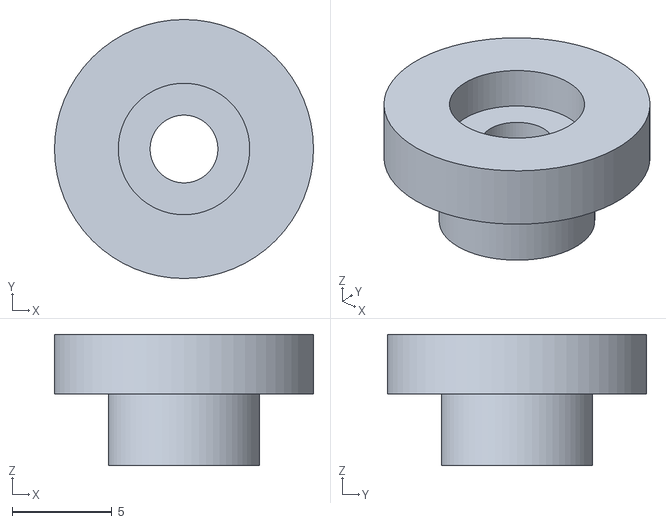
[picture p54: CAD file, 2026-08-24]
mechanical/enclosure-mounts/peg_cap.stl
13.0 x 13.0 x 6.60
