RileyLeff/sapflux_sensor/(list of files, cad)

Other CAD files:
mechanical/drill-guides/equidistant-6mm-bit-54.stl
mechanical/drill-guides/riley-10mm-5mm-bit-55.stl
