RileyLeff/sapflux_sensor/mechanical/drill-guides/previews/equidistant-6mm-bit-54.png

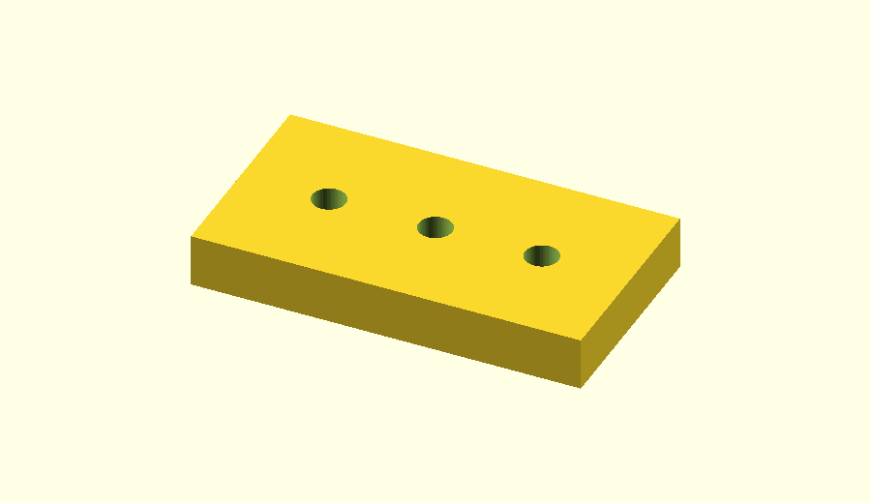
mechanical/drill-guides/previews/equidistant-6mm-bit-54.png
