RileyLeff/sapflux_sensor/east30docs/Steinhart-HartCoefficientsByCurve (1).pdf

# Steinhart-Hart Example Coefficients by Curve

# North Star Sensors

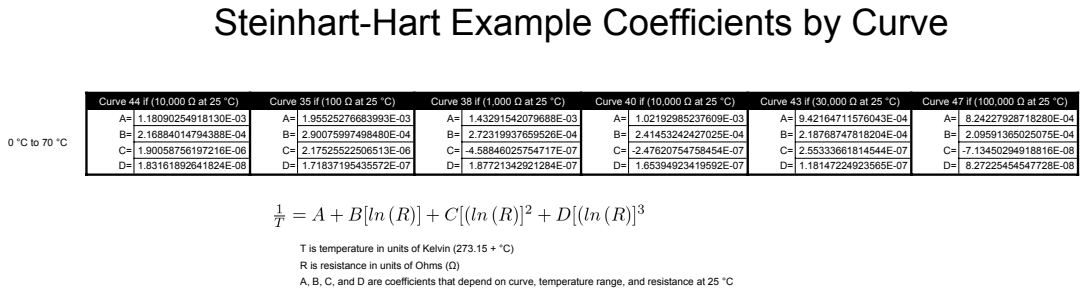
[picture p60: page 1]
Curve 44 if (10,000 Ω at 25 °C); Curve 35 if (100 Ω at 25 °C); Curve 38 if (1,000 Ω at 25 °C); Curve 40 if (10,000 Ω at 25 °C); Curve 43 if (30,000 Ω at 25 °C); Curve 47 if (100,000 Ω at 25 °C)

T is temperature in units of Kelvin (273.15 + °C)
R is resistance in units of Ohms (Ω)
A, B, C, and D are coefficients that depend on curve, temperature range, and resistance at 25 °C
