RileyLeff/sapflux_sensor/saptest1.kicad_pcb

## KiCad design saptest1.kicad_pcb (2026-02-19)

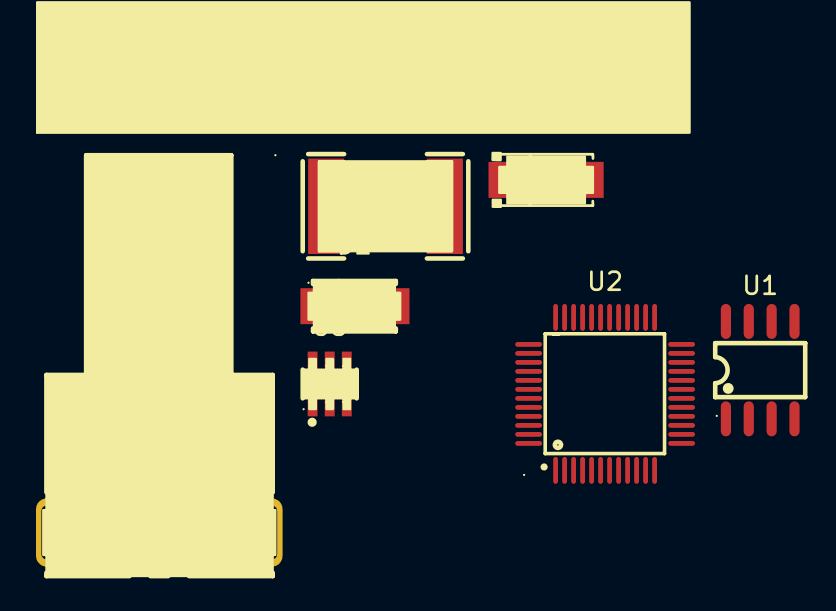
[picture p61: board saptest1.kicad_pcb from above]

Board: 2 copper layers, 8 parts (0 on the bottom side), 4 nets, no tracks yet.

Parts:
D1: SS36; SMA_L4.3-W2.6-LS5.2-RD
D2: SMAJ30A_C698947; SMA_L4.5-W2.6-LS5.1-RD
F1: 2920L110/60MR; F2920
J1: M8-P4A-GPL_M8-JD; CONN-TH_M8-P4A-GPL-M8-JD
U1: CAT24C32WI-GT3; SOIC-8_L5.0-W4.0-P1.27-LS6.0-BL
U2: STM32G0B1CBT6; LQFP-48_L7.0-W7.0-P0.50-LS9.0-BL
U3: KF2EDGV-3_5-10P; CONN-TH_10P-P3.50_KF2EDGV-3.5-10P
U5: LMR14006YDDCR; TSOT-23-6_L2.9-W1.6-P0.95-LS2.8-BL

Connections:
+24V Protected: D1.1 (K), D2.1
GND: D2.2, J1.3
unnamed: D1.2 (A), F1.2
unnamed: F1.1, J1.1
