RileyLeff/sapflux_sensor/elec/layouts/default/default.kicad_pcb

## KiCad design elec/layouts/default/default.kicad_pcb (2026-06-26)

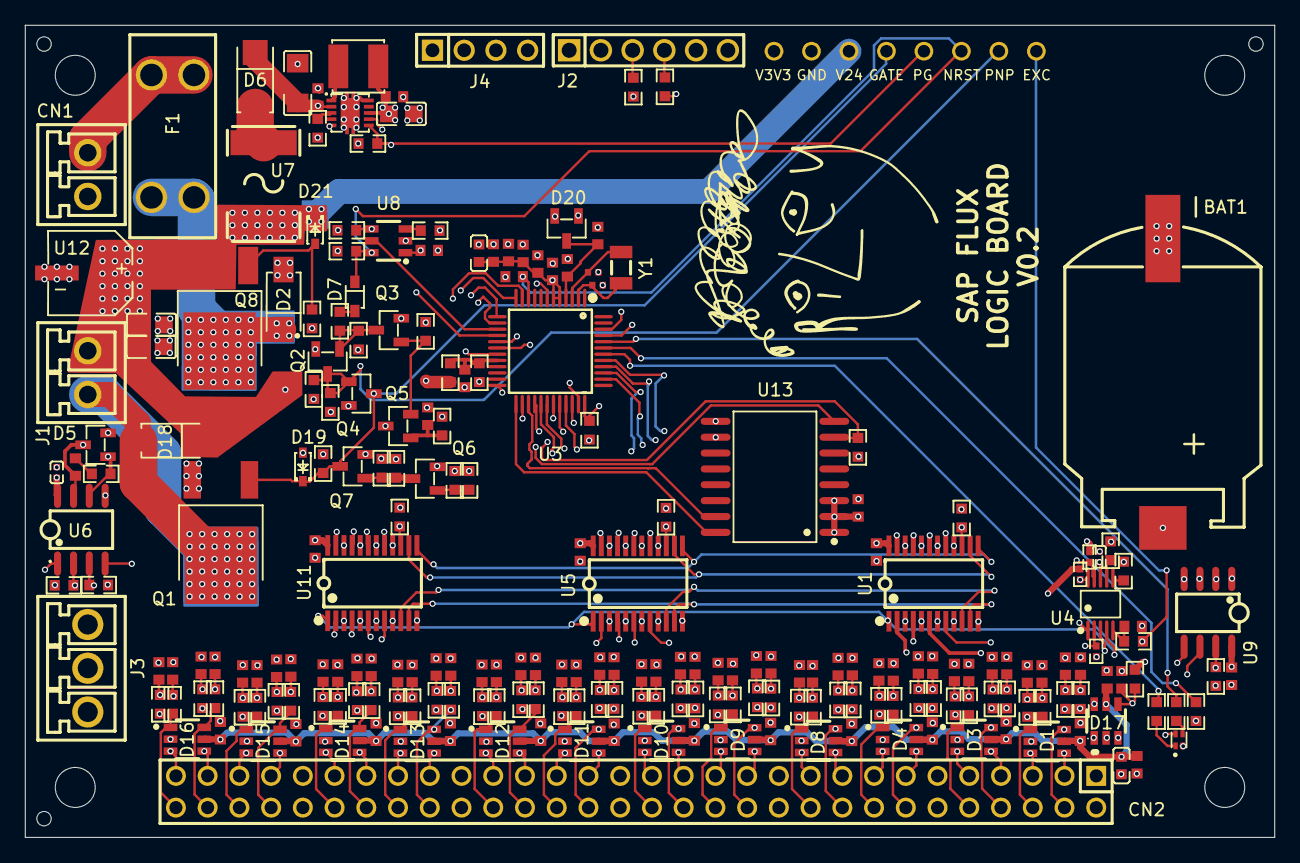
[picture p62: board default.kicad_pcb from above]

Board: 6 copper layers, 100.0 x 65.0 mm, 248 parts (0 on the bottom side), 169 nets.

Parts:
BAT1: BAT-SMD_BS-CR2032-8
C1: C1206
C2, C4, C5, C6, C8, C9, C10, C12, C13, C14, C15, C16, C17, C18, C19, C20, C21, C23, C24, C25, C26, C27, C28, C29, C30, C31, C32, C33, C34, C35, C36, C37, C38, C39, C40, C41, C42, C43, C44, C45, C46, C47, C48, C49, C50, C51, C52, C53, C54, C55, C56, C57, C58, C59, C60, C61, C62, C63, C64, C65, C66, C67, C68, C69, C70, C71, C72, C73, C74, C75, C76, C77, C78, C79, C80, C81, C82, C83, C84, C85, C86, C87, C88: C0603
C3, C7, C91: C0805
C11, C22: 100nF ±10%; C0402
C89, C90: C0402
CN1: CONN-TH_P3.50_KF2EDGV-3.5-2P
CN2: HDR-TH_60P-P2.54-V-M-R2-C30-S2.54
D1, D3, D4, D8, D9, D10, D11, D12, D13, D14, D15, D16, D17: SOT-23-6_L2.9-W1.6-P0.95-LS2.8-BR
D2, D18: SMA_L4.3-W2.6-LS5.0-RD
D5, D20: SOT-23-3_L2.9-W1.3-P1.90-LS2.4-BR
D6: SMA_L4.3-W2.6-LS5.2-RD
D7: SOD-323_L1.8-W1.3-LS2.5-RD
D19, D21: SOD-323_L1.7-W1.3-LS2.6-RD
EXC: TestPoint_Pad_D1.5mm
F1: FUSE-TH_4P-L16.0-W6.7
GATE: TestPoint_Pad_D1.5mm
GND: TestPoint_Pad_D1.5mm
H1, H2, H3, H4: MountingHole_3.2mm_M3
J1: CONN-TH_P3.50_KF2EDGV-3.5-2P
J2: HDR-TH_6P-P2.54-V-M-1
J3: CONN-TH_3P-P3.50_KF2EDGV-3.5-3P
J4: HDR-TH_4P-P2.54-V-M
L1: IND-SMD_L4.0-W4.0
L2, L3: L0603
NRST: TestPoint_Pad_D1.5mm
PG: TestPoint_Pad_D1.5mm
PNP: TestPoint_Pad_D1.5mm
Q1: TO-252-2_L6.6-W6.2-P4.57-LS10.1-BR-CW
Q2, Q3, Q4, Q5, Q6, Q7: SOT-23-3_L2.9-W1.3-P1.90-LS2.4-BR
Q8: TO-252-2_L6.5-W5.6-P4.60-LS9.7-BR
R1: R0603
R2, R21, R26, R33, R74, R75, R76, R79, R82, R85: 10kΩ ±1%; R0603
R3, R4, R5: 10kΩ ±1%; R0402
R6, R7, R8, R9, R10, R11, R12, R13, R14, R15, R20, R24, R35, R36, R37, R38, R39, R40, R41, R42, R43, R44, R45, R46, R47, R48, R49, R50, R51, R52, R53, R54, R55, R56, R57, R58, R59, R60, R61, R62, R63, R64, R65, R66, R67, R68, R69, R70, R71, R72, R73, R77, R78: 1kΩ ±1%; R0603
R16: 270Ω ±1%; R0603
R17, R18: 68kΩ ±1%; R0603
R19: 120Ω ±1%; R0603
R22: 11kΩ ±1%; R0603
R23, R27, R28, R29, R81: 100kΩ ±1%; R0603
R25, R34: 1MΩ ±1%; R0603
R30: 220Ω ±1%; R0603
R31: 200Ω ±1%; R0603
R32: 680Ω ±1%; R0603
R80: 10MΩ ±1%; R0603
R83: 2MΩ ±1%; R0603
R84, R86, R88: 4.7MΩ ±1%; R0603
R87: 470kΩ ±1%; R0603
TH1, TH2, TH3: ToolingHole_1.152mm
U1, U5, U11: TSSOP-24_L7.8-W4.4-P0.65-LS6.4-BL
U2: VSON-10_L3.0-W3.0-P0.50-TL-EP
U3: LQFP-48_L7.0-W7.0-P0.50-LS9.0-BL
U4: MSOP-10_L3.0-W3.0-P0.50-LS5.0-BL
U6, U9: SOIC-8_L5.0-W4.0-P1.27-LS6.0-BL
U7: F2920
U8: SOT-23-6_L2.9-W1.6-P0.95-LS2.8-BR
U10: LED-SMD_4P-L1.2-W1.2_BR
U12: CAP-SMD_BD6.3-L6.6-W6.6-LS7.2-FD
U13: SOIC-16_L10.3-W7.5-P1.27-LS10.3-BL
V3V3, V24: TestPoint_Pad_D1.5mm
Y1: FC-135R_L3.2-W1.5

Connections:
1: L1.1, U2.1
2: BAT1.2, D20.2
3: J2.3, R78.2
4: J2.4, R77.2
6: R72.1, U4.6
7: R73.1, U4.7
10: U1.10, U3.38, U5.10, U11.10
11: U1.11, U3.39, U5.11, U11.11
13: U1.13, U3.41, U5.13, U11.13
14: U1.14, U3.40, U5.14, U11.14
ALERT_RDY: R3.1, U3.19, U4.2
B: R30.1, U10.3
D: D19.1, GATE.1, Q1.1, Q4.3, Q7.3, R84.2
DELAY_M_RST: R22.1, U8.3
EXC: C20.1, CN2.2, CN2.22, CN2.42, D17.4, EXC.1, R15.1, R16.2
G: R31.1, U10.4
GND: BAT1.1, C1.2, C2.2, C3.2, C4.2, C5.2, C6.2, C7.2, C8.2, C9.2, C10.2, C11.2, C12.2, C13.2, C14.2, C15.2, C16.2, C17.2, C18.2, C19.2, C20.2, C22.2, C23.2, C24.2, C25.2, C26.2, C27.2, C28.2, C29.2, C30.2, C31.2, C32.2, C33.2, C34.2, C35.2, C36.2, C37.2, C38.2, C39.2, C40.2, C41.2, C42.2, C43.2, C44.2, C45.2, C46.2, C47.2, C48.2, C49.2, C50.2, C51.2, C52.2, C53.2, C54.2, C55.2, C56.2, C57.2, C58.2, C59.2, C60.2, C61.2, C62.2, C63.2, C64.2, C65.2, C66.2, C67.2, C68.2, C69.2, C70.2, C71.2, C72.2, C73.2, C74.2, C75.2, C76.2, C77.2, C78.2, C79.2, C80.2, C81.2, C82.2, C83.2, C84.2, C85.2, C86.2, C87.2, C88.2, C89.2, C90.2, C91.2, CN1.2, CN2.1, CN2.11, CN2.12, CN2.21, CN2.31, CN2.32, CN2.41, CN2.51, CN2.52, D1.2, D2.2, D3.2, D4.2, D5.2, D8.2, D9.2, D10.2, D11.2, D12.2, D13.2, D14.2, D15.2, D16.2, D17.1, D17.2, D17.3, D17.6, D19.2, GND.1, J2.1, J2.2, J3.3, J4.4, Q1.3, Q3.2, Q4.2, Q6.2, Q7.2, R1.2, R2.2, R17.2, R18.2, R22.2, R25.2, R26.2, R28.2, R72.2, R73.2, R81.2, R83.2, R87.2, R88.2, U1.12, U2.5, U2.10, U2.11, U3.7, U4.1, U4.3, U5.12, U6.5, U8.2, U9.1, U9.2, U9.3, U9.4, U11.12, U12.2, U13.10
ILIM: R1.1, U2.3
NRST: C9.1, D7.1, NRST.1, R27.1, U3.10, U8.6
PC15_OSC32_OUT: C90.1, U3.3, Y1.2
PGOOD: PG.1, R34.1, R85.1, U2.6, U3.31
Q_REV_GATE: D21.2, Q8.1, R88.1
R: R32.1, U10.1
RS485_TERM: C21.1, R19.2
RX: U3.14, U6.1
SCL: R4.1, R77.1, U3.45, U4.10, U9.6
SDA: R5.1, R78.1, U3.46, U4.9, U9.5
TX: U3.13, U6.4
V3V3: C3.1, C4.1, C5.1, C11.1, C22.1, C23.1, C69.1, C70.1, C71.1, C85.1, J4.1, L1.2, L2.1, L3.1, Q2.2, R3.2, R4.2, R5.2, R27.2, R29.2, R33.2, R74.2, R75.2, R76.2, R79.2, R85.2, U1.24, U2.8, U4.8, U5.24, U6.8, U8.1, U9.8, U10.2, U11.24, U13.1, U13.2, U13.3, U13.9, V3V3.1
V3V3_TVS: C68.1, C72.1, C73.1, C74.1, C75.1, C76.1, C77.1, C78.1, C79.1, C80.1, C81.1, C82.1, C83.1, C84.1, D1.5, D3.5, D4.5, D8.5, D9.5, D10.5, D11.5, D12.5, D13.5, D14.5, D15.5, D16.5, D17.5, L3.2
V24_BUCK: C1.1, C2.1, D6.1, U2.2, U2.7
V24_FUSED_RAW: D2.1, F1.2, F1.3, Q8.3
V24_PROT: C7.1, C91.1, D18.1, D21.1, J1.1, Q8.2, R80.1, R84.1, R86.1, U7.1, U12.1, V24.1
V24_RAW: CN1.1, F1.1, F1.4
VDDA_FILT: C8.1, C10.1, C24.1, C25.1, C88.1, D20.1, L2.2, U3.5, U3.6
WP: R33.1, U3.34, U9.7
Z: U1.1, U4.4, U5.1, U11.1
arm_node: C28.1, Q5.1, R34.2
blue: R30.2, U3.44
cs: R79.1, U3.24, U13.7
ctrl_gate_node: Q6.1, R81.1, R82.2
d_iso_anode_node: D7.2, R21.1
de: R17.1, U3.12, U6.3
done: R28.1, U3.16, U8.4
driver_gate_node: Q6.3, Q7.1, R80.2, R83.1
excitation_gpio: R16.1, U3.30
fb_out_node: Q5.3, R23.2
gate_drive: R82.1, U3.28
gpio_pa6: J2.5, U3.17
gpio_pa7: J2.6, U3.18
green: R31.2, U3.43
heater_lo: D18.2, J1.2, Q1.2
latch_base_node: Q3.1, Q5.2, R25.1
mcu-1: C86.1, C87.1, D20.3, U3.4
mcu-1-1: C89.1, U3.2, Y1.1
miso: U3.26, U13.8
mosi: U3.27, U13.15
mux_en_a: R74.1, U1.15, U3.29
mux_en_b: R75.1, U3.32, U5.15
mux_en_c: R76.1, U3.33, U11.15
n_re: R18.1, U3.11, U6.2
pnp_base_node: Q2.1, Q3.3, R21.2, R29.1
pnp_coll_node: PNP.1, Q2.3, Q4.1, R23.1, R26.1
prot_1: C12.1, R6.2, U1.8
prot_2: C13.1, R7.2, U1.9
prot_3: C14.1, R8.2, U1.6
prot_4: C15.1, R9.2, U1.7
prot_5: C16.1, R10.2, U1.4
prot_6: C17.1, R11.2, U1.5
prot_7: C18.1, R12.2, U1.2
prot_8: C26.1, R13.2, U1.3
prot_9: C27.1, R14.2, U1.17
prot_10: C29.1, R20.2, U1.16
prot_11: C30.1, R24.2, U1.19
prot_12: C31.1, R35.2, U1.18
prot_13: C32.1, R36.2, U1.21
prot_14: C33.1, R37.2, U1.20
prot_15: C34.1, R38.2, U1.23
prot_16: C35.1, R39.2, U1.22
prot_17: C36.1, R40.2, U5.8
prot_18: C37.1, R41.2, U5.9
prot_19: C38.1, R42.2, U5.6
prot_20: C39.1, R43.2, U5.7
prot_21: C40.1, R44.2, U5.4
prot_22: C41.1, R45.2, U5.5
prot_23: C42.1, R46.2, U5.2
prot_24: C43.1, R47.2, U5.3
prot_25: C44.1, R48.2, U5.17
prot_26: C45.1, R49.2, U5.16
prot_27: C46.1, R50.2, U5.19
prot_28: C47.1, R51.2, U5.18
prot_29: C48.1, R52.2, U5.21
prot_30: C49.1, R53.2, U5.20
prot_31: C50.1, R54.2, U5.23
prot_32: C51.1, R55.2, U5.22
prot_33: C52.1, R56.2, U11.8
prot_34: C53.1, R57.2, U11.9
prot_35: C54.1, R58.2, U11.6
prot_36: C55.1, R59.2, U11.7
prot_37: C56.1, R60.2, U11.4
prot_38: C57.1, R61.2, U11.5
prot_39: C58.1, R62.2, U11.2
prot_40: C59.1, R63.2, U11.3
prot_41: C60.1, R64.2, U11.17
prot_42: C61.1, R65.2, U11.16
prot_43: C62.1, R66.2, U11.19
prot_44: C63.1, R67.2, U11.18
prot_45: C64.1, R68.2, U11.21
prot_46: C65.1, R69.2, U11.20
prot_47: C66.1, R70.2, U11.23
prot_48: C67.1, R71.2, U11.22
prot_exc: C19.1, R15.2, U4.5
ptc_out: D6.2, U7.2
red: R32.2, U3.42
rs485_a_P: D5.1, J3.1, R19.1, U6.6
rs485_b_N: C21.2, D5.3, J3.2, U6.7
sck: U3.25, U13.16
swclk: J4.3, R2.1, U3.36
swdio: J4.2, U3.35
therm_1: CN2.3, D1.4, R6.1
therm_2: CN2.4, D1.6, R7.1
therm_3: CN2.5, D1.3, R8.1
therm_4: CN2.6, D1.1, R9.1
therm_5: CN2.7, D3.4, R10.1
therm_6: CN2.8, D3.6, R11.1
therm_7: CN2.9, D3.3, R12.1
therm_8: CN2.10, D3.1, R13.1
therm_9: CN2.13, D4.4, R14.1
therm_10: CN2.14, D4.6, R20.1
therm_11: CN2.15, D4.3, R24.1
therm_12: CN2.16, D4.1, R35.1
therm_13: CN2.17, D8.4, R36.1
therm_14: CN2.18, D8.6, R37.1
therm_15: CN2.19, D8.3, R38.1
therm_16: CN2.20, D8.1, R39.1
therm_17: CN2.23, D9.4, R40.1
therm_18: CN2.24, D9.6, R41.1
therm_19: CN2.25, D9.3, R42.1
therm_20: CN2.26, D9.1, R43.1
therm_21: CN2.27, D10.4, R44.1
therm_22: CN2.28, D10.6, R45.1
therm_23: CN2.29, D10.3, R46.1
therm_24: CN2.30, D10.1, R47.1
therm_25: CN2.33, D11.4, R48.1
therm_26: CN2.34, D11.6, R49.1
therm_27: CN2.35, D11.3, R50.1
therm_28: CN2.36, D11.1, R51.1
therm_29: CN2.37, D12.4, R52.1
therm_30: CN2.38, D12.6, R53.1
therm_31: CN2.39, D12.3, R54.1
therm_32: CN2.40, D12.1, R55.1
therm_33: CN2.43, D13.4, R56.1
therm_34: CN2.44, D13.6, R57.1
therm_35: CN2.45, D13.3, R58.1
therm_36: CN2.46, D13.1, R59.1
therm_37: CN2.47, D14.4, R60.1
therm_38: CN2.48, D14.6, R61.1
therm_39: CN2.49, D14.3, R62.1
therm_40: CN2.50, D14.1, R63.1
therm_41: CN2.53, D15.4, R64.1
therm_42: CN2.54, D15.6, R65.1
therm_43: CN2.55, D15.3, R66.1
therm_44: CN2.56, D15.1, R67.1
therm_45: CN2.57, D16.4, R68.1
therm_46: CN2.58, D16.6, R69.1
therm_47: CN2.59, D16.3, R70.1
therm_48: CN2.60, D16.1, R71.1
vmon_mid: C6.1, R86.2, R87.1, U3.20
wake: U3.15, U8.5
