RileyLeff/sapflux_sensor/software/sfk1/src/profile.rs

//! [`Profile`]: everything about a sensor's sampling and its trained tables
//! that the encoder and decoder must agree on.

use core::fmt;

use crate::tables;

/// Fixed-size scratch arrays a [`Profile`] names for the encoder's
/// per-channel state: `[i64; L]` and `[i32; L]` for any `L`.
///
/// Implemented for plain arrays only (sealed); a profile writes e.g.
/// `type Acc = [i64; 16];`.
///
/// ```
/// use sfk1::Array;
/// assert_eq!(<[i64; 16] as Array<i64>>::LEN, 16);
/// ```
pub trait Array<T>: Copy + AsRef<[T]> + AsMut<[T]> + sealed::Sealed {
    /// Number of elements.
    const LEN: usize;
    /// The all-zero array.
    const ZERO: Self;
}

mod sealed {
    pub trait Sealed {}
    impl<const L: usize> Sealed for [i64; L] {}
    impl<const L: usize> Sealed for [i32; L] {}
}

impl<const L: usize> Array<i64> for [i64; L] {
    const LEN: usize = L;
    const ZERO: Self = [0; L];
}

impl<const L: usize> Array<i32> for [i32; L] {
    const LEN: usize = L;
    const ZERO: Self = [0; L];
}

/// A sensor shape and its trained tables: the sampling grid, the log-time
/// spline basis, the KLT matrices and the entropy-coder parameters.
///
/// The channel count is not part of the profile; it is the `N` of
/// [`Encoder<N, P>`](crate::Encoder), so one profile serves any number of
/// thermistors that share the same probe geometry and sample rate.
///
/// Implement it on a unit struct. Items with defaults hold the values of
/// the East30 format (25 Hz, 5 s bins, 181 s after onset); override what
/// your sensor changes. The trained tables (`MQ`, `D`, `K_TABLE`) and
/// `KF_Q28` come from `tools/generate.py --profile` (see the crate docs,
/// [Defining your own profile](crate#defining-your-own-profile)).
///
/// Invariants are checked at compile time as soon as an
/// [`Encoder`](crate::Encoder) or [`Decoder`](crate::Decoder) is built for
/// the profile (the error names the broken rule), and at run time by
/// [`validate`](Self::validate).
///
/// ```
/// use sfk1::{East30K12, Profile};
/// assert_eq!(East30K12::KNOTS, 12);
/// assert_eq!(East30K12::n_coefs(), 16);
/// assert!(East30K12::validate().is_ok());
/// ```
///
/// A broken profile does not build once it is used:
///
/// ```compile_fail
/// use sfk1::{East30K12, Encoder, Profile};
/// struct Bad;
/// impl Profile for Bad {
///     const NAME: &'static str = "bad";
///     type Bins = [i32; 12];
///     const KNOTS: u8 = 12;
///     type Acc = [i64; 15]; // must be KNOTS + 4 = 16
///     const KF_Q28: i64 = East30K12::KF_Q28;
///     const MQ: &'static [i32] = East30K12::MQ;
///     const D: &'static [f64] = East30K12::D;
///     const K_TABLE: &'static [u8] = East30K12::K_TABLE;
/// }
/// let _ = Encoder::<12, Bad>::new(&[0, 1], 12); // error: Acc is not [i64; KNOTS + 4]
/// ```
pub trait Profile: Sized + 'static {
    /// Human-readable name, for logs.
    const NAME: &'static str;

    /// Version byte of the compact 6-byte header (`0x53`/`0x54` for the
    /// East30 profiles), used when `N = 12`. `None` (the default) always
    /// writes the extended header.
    const COMPACT_VERSION: Option<u8> = None;

    /// 32-bit profile id in the extended header; a decoder refuses a record
    /// whose id is not its profile's. Defaults to [`fingerprint`] of the
    /// profile, so any change to a table changes the id.
    const ID: u32 = fingerprint::<Self>();
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
