RileyLeff/sapflux_sensor/(commit log)

2026-02-19 Atopile schematic implementation — all 9 modules, BOM validated
    Complete atopile (code-based PCB design) implementation of the sap flux
    sensor adapter board. 9 .ato modules: protection, buck, mcu, adc, rs485,
    heater, led, connectors, and main (top-level wiring with MCU GPIO
    assignments). All imported LCSC parts with fixed pin names, 3 registry
    packages (ADS1115, SP3485, 24LC32). Builds clean, BOM validated: 39 line
    items, 83 components, all in stock at JLCPCB.
    Also includes original KiCad schematics, common_lib footprints/3D models,
    design documentation, and East30 sensor datasheets.
2026-02-19 Swap EEPROM from registry Microchip 24LC32AT to onsemi CAT24C32
    Saves $0.27/board by using the design doc part (C81193, $0.33) instead
    of the registry package (C616245, $0.60). Manual wiring replaces the
    registry module's auto-generated pull-ups and decoupling. I2C pull-ups
    now 5kΩ effective (2x 10kΩ from ADS1115 packages), within fast mode spec.
2026-02-19 Address review findings: TVS decoupling, floating ADC input, DONE pull-down
    - Add local 100nF decoupling caps (c_esd_a, c_esd_b) for PRTR5V0U4D TVS
    arrays in adc.ato — absorbs ESD dump current, prevents 3.3V rail bounce
    - Tie unused ADC2 AIN3 to GND to prevent floating input noise coupling
    - Add 100kΩ DONE pull-down on TPL5010 for deterministic behavior during
    MCU reset
    - Remove stale C3 bootstrap cap from design doc (LM5165Y P-FET high side
    has internal bootstrap)
    - Update design doc C14663 instance count and add R_DONE_PD to BOM
2026-02-19 Add R_PNP_BASE (100kΩ) to define PNP OFF state in SCR latch
    PNP base floats when D_ISO is reverse-biased and Q_LATCH is off
    (normal operation). In noisy outdoor environments, leakage or
    coupled noise could forward-bias the base-emitter junction, causing
    spurious heater lockout. 100kΩ pull-up to 3.3V (emitter) gives
    140x margin over transistor leakage at 85°C while preserving latch
    function (hFE needed = 1.4 vs MMBT3904 min 100). No new part
    number — uses C25803 already in BOM.
2026-02-19 Add PGOOD-gated latch arming to prevent TPL5010 POR from triggering SCR latch
    TPL5010 asserts RSTn LOW for ~60ms at every power-on, which would trigger
    the SCR latch and permanently lock out the heater before the MCU boots.
    Q_ARM (2N7002) in the R_FB path breaks the feedback loop until PGOOD
    charges arm_node through a 1MΩ/1µF RC (τ=1s, ≥361ms worst-case arming
    delay vs 100ms max tRST = 3.6× margin). All three components use existing
    BOM part numbers.
2026-02-19 Fix C2 MPN in design doc, clarify heater pin polarity and termination topology
    - C2 MPN: C2012X5R1A226M125AC -> C2012X5R1A226KT000N (matches C76634)
    - J2 pins 1-2: clarify board-side assignment (non-polar refers to element)
    - R_TERM: note hard-populated because adapter is always end-of-line
2026-02-19 Place all components into functional zones on 4-layer 90x62mm board
    Python script places all 88 components by atopile_address into zones:
    - Input protection + buck converter (upper left)
    - RS-485 transceiver (left center)
    - STM32G0B1 MCU at 180deg (center, I2C right, UART left)
    - ADC ICs + I2C pullups + EEPROM (upper right)
    - ADC input protection filters (right center)
    - Status LED (upper center)
    - Heater driver + SCR latch + TPL5010 (lower center-left)
    - Connectors: M8 left edge, 10-pin bottom edge
    Also adds: 4-layer stackup (Signal/GND/3.3V/Signal), board outline,
    4x M3 mounting holes, 3x asymmetric fiducials, GND+3.3V zone fills.
    Removes all atopile auto-traces (will be routed manually i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
2026-02-19 Fix ESD protection order: move TVS to connector side of series resistors
    PRTR5V0U4D TVS arrays now clamp directly at the connector-side net
    (thermistor_X) instead of the post-resistor node (prot_X). With the
    previous topology, an 8kV ESD strike would develop multi-kV across the
    0603 resistor before the TVS could clamp. Now the TVS absorbs the
    transient immediately, and the 1kΩ + 100nF RC filter handles the
    remaining clamped voltage. Affects all 7 ADC input channels.
    Caught by Gemini 3.1 Pro review.
2026-02-23 Add JLCPCB design rules, 4-layer stackup, net classes, and project file
    Phase 0 of PCB layout: verification infrastructure.
    - default.kicad_dru: JLCPCB 4-layer custom DRC rules (trace width,
    clearance, via drill, annular ring, hole spacing, edge clearance,
    silkscreen minimums)
    - default.kicad_pro: KiCad project file with 5 net classes
    (Default 0.2mm, Power_24V 0.5mm, Power_3V3 0.3mm, Analog 0.2mm,
    GND 0.3mm), pattern-based net assignments, global design constraints
    - default.kicad_pcb: Fixed stackup from 2-layer to 4-layer JLC7628
    (F.Cu/prepreg/In1.Cu GND/core/In2.Cu 3.3V/prepreg/B.Cu),
    solder mask expansion set to 0.051mm
    - .gitignore: Unignore .kicad_dru files (DRC rules shoul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
2026-02-24 Rename auto-numbered nets and fix netclass patterns
    Add signal declarations in atopile for readable net names:
    - BOOT0 (was mcu.package-1), RS485_TERM (was auto-numbered),
    M8_SHIELD (was connectors-1), VDDA_FILT (source variable rename)
    Fix netclass patterns: hv→Power_3V3 (3.3V rail, was incorrectly
    Power_24V), power_out-hv→Power_24V (24V protected, was incorrectly
    Power_3V3), added mcu-1→Power_3V3 for VDDA filtered rail.
    Fix pad_to_mask_clearance float→int parse error in PCB file.
2026-02-24 Fix power rail net names using signal+override_net_name workaround
    Atopile bug: override_net_name on ElectricPower.hv/.lv is shadowed by
    the class's pre-existing SUGGESTED trait (try_get_trait returns first
    match by insertion order, always finding SUGGESTED before EXPECTED).
    Workaround: create standalone signal nodes with override_net_name,
    connected to power rails. The net naming algorithm's hierarchy walk
    finds the EXPECTED trait on the standalone signal.
    Net renames: hv→V3V3, lv→GND, power_in-hv→V24_RAW, power_out-hv→V24_PROT,
    mcu-1→VDDA_FILT. Netclass patterns updated to match new names.
2026-02-24 Route power protection circuit and begin component placement
    Routed: CN1 → U1 (PTC) → node_a → D2 (TVS to GND) + D1 (Schottky to V24_PROT).
    M8 shield cap (C24) connected. GND vias at D2 and C24.
    Began reorganizing component zones for revised floorplan:
    buck top-left, RS-485 left-center, MCU center, ADC top-right,
    heater bottom-left, thermistor filters bottom-right.
2026-02-24 Organize all components into functional zones
    All 88 components placed into zones per revised floorplan:
    - Protection + buck: upper-left
    - RS-485: lower-left
    - MCU + decoupling: center
    - ADC + I2C: upper-right
    - Thermistor input filters: center-right
    - Heater + safety latch: bottom
    - LED: center
    - CN1 (M8): left edge, CN2 (10-pin): right edge
    No routing yet — placement only. Ready for zone-by-zone routing.
2026-02-26 current state
2026-03-02 Add v1.1 revision plan and per-repo napkin
    proposed_v1.1_revisions.md: Complete v1.1 design change document
    covering 32-channel mux expansion, gate driver, flash/RTC/VBAT,
    48-pin connector, and power path changes. Includes all round-2
    bug fixes (pin reassignments, gate driver narrative, D1 thermal,
    boot-state pull-ups, AIN1 routing, EEPROM WP).
    .claude/napkin.md: Per-repo mistake tracking with corrections for
    LQFP-48 pin availability, gate driver boot behavior, and domain
    notes for the design.
2026-03-02 Rewrite dual excitation to single excitation line
    External review found the dual-excitation AIN1 topology created a
    summing node (inactive GPIO pulled AIN1 to ~2.0V). Fix: single
    excitation line (PC6, 270 ohm R_EXC) eliminates the bug entirely.
    Changes: Section 2 (single exc + ratiometric sense), Section 5
    (TVS spare count fix), Section 6 (PA11 freed), Section 7 (BOM:
    270 ohm C22966 replaces 560 ohm), Section 11 (connector pinout),
    Resolved Items (updated narrative).
2026-03-02 Add PGOOD-gated heater gate pull-up to eliminate boot glitch
    Q_PGOOD (2N7002) in series with D_ZENER gates R_GATE_PULL. Until
    buck output is stable (PGOOD HIGH), Q_PGOOD is OFF and Q1 gate
    cannot charge — heater stays OFF during entire boot sequence.
    Zero cost (reuses existing 2N7002 BOM line).
2026-03-02 Add D1 thermal mitigation, fuse default, SCR latch documentation
    - D1: thermal vias + copper pour under SMA pad, SMC fallback note
    - Heater fuse: populated by default (not optional bridge)
    - SCR latch kill path: full 6-step sequence documented explicitly,
    recovery requires power cycle (intentional anti-footgun)
2026-03-02 Add EEPROM WP, VBAT cap, firmware notes from external review
    - EEPROM WP: PA12 with 10k pull-up (boot-safe: writes blocked)
    - VBAT: 1uF buffer cap for domain switchover transient
    - Firmware notes: LSEDRV cold startup, flash erase scheduling,
    ADC health monitoring, EEPROM write protection protocol
    - BOM: 4th pull-up resistor, VBAT cap (existing C15849)
    - Fixed lingering dual-excitation reference in connector rationale
2026-03-03 Redesign gate driver: remove broken N-ch PGOOD, add R_PA8_PU default-ON
    N-channel MOSFET cannot gate a high-side pull-up (Vgs goes negative as
    source follows output). Replace with R_PA8_PU (10k to V3V3) making
    Q_DRIVER default-ON during boot. R_GATE_PULL 100k→1M reduces sleep
    current to 24µA and limits boot glitch to ~1ms (thermally negligible).
2026-03-03 Fix MOSFET Rds(on) (75mΩ not 12mΩ) and W25Q256 SOIC-16 pin numbers
    TM15N10D Rds(on) is 75mΩ@10V per JLCPCB spec, not 12mΩ. Corrected
    power table: 8 heaters = 1,565mW (31°C rise), still safe but not
    "trivial". Fixed W25Q256JVFIQ pin mapping for correct SOIC-16 package
    (was using SOIC-8 pin numbers). Package is TO-252-3L not TO-252-2L.
2026-03-03 Fix BOM counts, extended fee, and sleep power budget
    - 100nF count: 28 → 29 (26 filters + 3 decoupling)
    - 10k pull-ups: 4 → 5 (add R_PA8_PU for gate driver)
    - Extended parts: 7 → 8 (PRTR5V0U4D was missed), fee $21 → $24
    - Sleep power: gate driver is 24µA from 24V, not ~0µA
    - Add R_EXC (560Ω) to parts-removed table
    - Add TH assembly cost note (~$2-3/board surcharge)
    - Per-board cost: $10.17 at 5 boards, $5.85 at 50
2026-03-03 Fix stale text, scan rates, data budget, stock warnings, and misc
    - M2: "hardware differential mode" → "single-ended ratiometric"
    - M3: Remove false SMA/SMC footprint compatibility claim
    - M4: Scan rate table uses 2 conv/ch (dummy+real for mux settling)
    - L1: Flash price note ($3.92 qty 10+, $4.26 qty 1)
    - L4: Data budget: ~250 scans/cycle (not 2,800), with breakdown
    - L5: 3.3V headroom ~23mA not 3mA; PFM ripple is the real reason
    - L6: BAT54S VBAT transient protection note
    - M7/M8: Stock warnings for PRTR5V0U4D (2,617) and 48P header (817)
    - Resolve stale TBD connector reference (now specified as C22465947)
2026-03-03 Add SWD header and test points section to v1.1 doc
    4-pin SWD header (SWDIO, SWCLK, GND, NRST) for programming with
    ST-Link/J-Link. 9 test points grouped by function: power rails
    (V24_PROT, V3V3, PGOOD), analog (VDDA_FILT, excitation), heater
    (Q1 gate, SCR latch), plus 3 local GND references. Includes
    first-board bring-up sequence.
2026-03-03 Add buck-dead fail-safe to gate driver via Q_CTRL isolation
    GPT Pro review found that the R_PA8_PU gate driver design fails
    if 24V is present but the 3.3V buck is dead — all four safety
    layers depend on 3.3V, so the heater turns ON indefinitely.
    Fix: bias Q_DRIVER from a 24V voltage divider (R_BIAS 4.7M +
    R_GATE_PD 1M = 4.2µA) so heater defaults OFF independent of
    3.3V. PA8 isolated through Q_CTRL (2N7002) to avoid STM32 ESD
    clamp back-feed at the divider node. Zero boot glitch. Logic
    polarity restored to match v1.0 (PA8 HIGH = heater ON).
2026-03-03 Add reviewer FAQ and firmware notes to v1.1 doc
    Design Notes section documents analyzed-and-resolved items to prevent
    re-flagging: mux Ron (6000x below noise floor), gate turn-on ramp
    (0.065% of pulse energy), D1 thermal with cable loss, buck headroom
    (53-63% utilization), and MODBUS compatibility.
    Firmware notes: heater inter-pulse cooldown, flash DPD wake sequence,
    EEPROM CRC integrity.
2026-03-03 Move D1 to buck-only branch, add cable spec, update BOM
    - D1 (SS36) moved from main series path to buck-only branch. Now
    carries <50 mA instead of full heater current. Eliminates thermal
    concern at any heater count.
    - PTC split topology: buck gets D1+PTC, heater gets dedicated fuse.
    - Added cable specification section: star topology, 16 AWG recommended,
    188 m max at 20% power drop.
    - Updated BOM: removed SS36 D1 from parts-removed (D1 stays, just
    moves). Net delta: +$5.35/board.
    - Updated D1 thermal FAQ (concern eliminated, not managed).
    - Updated inter-pulse cooldown note (MOSFET thermal, not D1).
2026-03-03 Add ESD rail isolation, mux leakage analysis, and 48-channel updates to v1.1 doc
    - Ferrite bead (L3, C1002) splits 3.3V into clean (MCU/ADC) and dirty (TVS VCC)
    rails for ESD transient isolation across 13 PRTR5V0U4D arrays
    - Mux leakage error budget: 4.8 mC worst realistic (60C, 100nA), well within
    10 mC target for sap flux derivative estimation
    - Updated all references from 32-channel/8-probe to 48-channel/12-probe
    - Fixed flash data budget for 48ch adaptive scan (167 scans, 16 KB/cycle, 44 days)
    - Added SPI/ADC noise isolation and heater wiring deployment notes
2026-03-03 Import 14 new LCSC parts for v1.1
    74HC4067 mux (C179326), W25Q256JVFIQ flash (C779876),
    TM15N10D MOSFET (C7422818), MM3Z10 zener (C19077459),
    60-pin 2x30 header (C2883964), KF2EDGV-3.5-2P terminal (C441321),
    CR2032 holder (C7498149), BAT54S Schottky (C7420333),
    32.768kHz crystal (C32346), SS56 diode (C18199169),
    fuse clip (C3130), 18pF C0G cap (C1549), 4.7M resistor (C23163),
    1x6 pin header (C37208).
    Fixed designator prefixes (J for connectors, Y for crystal, F for fuse)
    and added signal names to bare pins.
2026-03-04 Implement v1.1 atopile architecture: 48-ch mux, flash, gate driver
    All 9 .ato modules updated for v1.1. 225 components, 51 BOM line items.
    Module changes:
    - adc.ato: Single ADS1115 + 3x 74HC4067 mux (48 thermistor channels),
    ESD rail isolation ferrite, 13x PRTR5V0U4D TVS arrays, 49-ch input
    protection (1k + 100nF per channel)
    - heater.ato: TM15N10D DPAK MOSFET, 10V gate driver circuit
    (Q_CTRL + Q_DRIVER + MM3Z10 zener), SS56 flyback, fuse clips
    - mcu.ato: 32.768 kHz RTC crystal + 18pF load caps, CR2032 VBAT
    backup with BAT54S diode-OR
    - flash.ato: New W25Q256JVFIQ SPI flash module (32MB)
    - connectors.ato: 60-pin thermistor header, 2-pin heater terminal,
    1x6 aux header (I2C + spare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
2026-03-04 Add net name overrides for PGOOD, NRST, EXC, V3V3_TVS
    Readable net names for PCB layout debugging. PGOOD shared between
    buck/MCU/heater latch. NRST shared between MCU and TPL5010. EXC is
    the excitation output to connector. V3V3_TVS is the dirty TVS rail
    in the ADC module (matches spec Section 5 naming).
2026-03-04 Fix spec text: PTC→D1 order matches implementation, correct PA8 polarity note
    - PTC fuse topology diagram and description now shows PTC before D1
    (matching actual atopile implementation in main.ato)
    - GPIO table PA8 note changed from "inverted: LOW=on" to
    "non-inverted: HIGH=on" to match the state table and detailed
    gate driver description
2026-03-05 Replace M8 connector with screw terminals for prototype
    M8 rated 3A, heater draws 4.8A peak. Screw terminals (KF2EDGV 3.5mm,
    10A) for both power input (2-pin) and RS-485 (3-pin). Shield cap removed.
    Add fix_passive_layers.py script and just build recipe.
2026-03-05 Add netclasses, JLCPCB design rules, and coarse component placement
    Netclasses: Power_24V (3mm/0.8mm via) for V24_RAW/heater, Power_3V3
    (0.5mm), Analog (0.2mm/0.6mm via), GND (0.5mm). Via annular ring
    rule added. Passive silkscreen moved to F.Fab. Coarse placement of
    power input, buck converter, heater driver, and MCU sections.
2026-03-05 Update atopile modules and part footprints from v1.1 build
    Build artifacts: updated footprint geometry, part .ato metadata,
    and module changes from ato build.
2026-03-06 Add SWD header (J6), TVS pin swap on D1, protection placement script
    - Add 1x4 SWD programming header (J6): VCC/SWDIO/SWCLK/GND
    - Wire PA13 (SWDIO) and PA14_BOOT0 (SWCLK) to J6 via connectors module
    - Add power_3v3 interface to Connectors for J6 VCC reference
    - Swap therm_3/therm_4 TVS pins on D1 for easier routing
    - Add place_protection.py script for automated RC/TVS placement
    - Update PCB with analog section routing progress and TVS placement
2026-03-06 Swap ESD3/ESD4 on all 12 thermistor TVS arrays, align to connector pins
    Routing optimization: swap ESD3 (pin 1) and ESD4 (pin 3) on all
    PRTR5V0U4D TVS arrays (D1, D3, D4, D8-D16) to reduce trace crossings
    near the 60-pin connector. ESD channels are electrically identical.
    Align all 12 TVS arrays to D1's X position (263.55mm) and center each
    vertically on its 4 associated thermistor pins on CN2.
2026-03-06 Place 88 R/C input protection pairs aligned to connector pins
    Replicate D1 group placement pattern (R6-R9, C12-C15) for therms 5-48.
    Resistors at x=260.90, caps at x=258.23, rot=180, each pair spread
    ±0.5mm vertically centered on their CN2 thermistor pin Y position.
    Therms 1-4 (manually placed) left untouched.
2026-03-06 Reorder mux Y assignments for crossing-free routing
    Reassign prot_N → mux Y inputs to match physical board layout:
    - Near side (Y0-Y7): even/odd pairs top→bottom matching connector order
    - Far side (Y8-Y15): wrap-around, same even/odd pattern
    - All 3 muxes follow identical pattern offset by 16
    Firmware lookup table needed: mux address no longer equals thermistor
    number. Zero trace crossings between protection column and mux pins.
2026-03-06 Route prot_1-16 from protection column to mux U1, V3V3_TVS daisy chain
    All 16 thermistor channels for mux A routed with zero crossings.
    V3V3_TVS spine on B.Cu connecting all 13 TVS arrays through L3 ferrite.
    GND vias consolidated per cap pair to free B.Cu for prot_N routing.
2026-03-06 Route prot_17-48 to muxes U5 and U11, align mux column
    All 48 thermistor prot_N lines now routed from protection column
    to mux Y inputs. U5 and U11 aligned to U1's X position (240.66)
    with matching relative offset from their therm groups.
2026-03-07 Fix DRC footprint type mismatch and clearance violations
    - Change Q1 (TM15N10D DPAK) and L1 (XRNR4018 inductor) from attr
    through_hole to attr smd in source .kicad_mod and PCB (faebryk_convert
    misclassified these surface-mount parts)
    - Nudge prot_N filter cap pairs to meet 0.127mm outer-layer clearance
2026-03-07 Increase fuse clip pad height to meet JLCPCB PTH annular ring minimum
    F1/F2 (C3130) oval pads: 2.4x1.0mm → 2.4x1.1mm. Short-axis annular
    ring increases from 0.2mm to 0.25mm, meeting the 0.25mm JLCPCB spec.
    Source footprint and PCB copies both updated.
2026-03-10 Save working state before 6-layer stackup exploration
    PCB layout in progress (partially routed analog section), plus
    gerber exports, DRC outputs, cost/battery analysis, and review notes.
2026-03-12 Save layout progress: 6-layer upgrade, heater thermal vias, gerber re-export
    - 6-layer PCB stackup (In3.Cu, In4.Cu added for free POFV + ENIG)
    - Q1 DPAK drain pad: 7x7 thermal via grid with heater_lo pour on In3.Cu
    - GND via grid on Q1 source pad with copper pour
    - CR2032 battery holder moved to top side for single-side assembly
    - Gerber files re-exported for updated stackup
    - BOM and CPL files updated for JLC format
2026-03-12 Add 2x 10µF 50V ceramic bypass caps to heater 24V bulk decoupling
    Single 100µF electrolytic has ~1Ω ESR producing 5V spikes at 5A
    heater switching. Two Murata GRM21BR61H106KE43L (C440198, 0805,
    basic) in parallel provide ~5mΩ ESR path for fast transients.
2026-03-12 Add SPICE simulation, MOSFET explorer, and layout progress
    - spice/: ngspice heater section simulation (netlist + plotly visualization)
    confirms gate driver, SCR latch, PGOOD arming, and latch permanence
    - docs/mosfet-explorer.html: interactive 5-scenario MOSFET learning tool
    - PCB layout: continued component placement and grouping
    - common_lib: C0805 footprint and symbol updates
    - gerber re-export with current state
2026-03-13 Layout progress: buck section placement, passive layer fix, gitignore spice data
    - Buck converter: U2, C2, L1, R1 placed per TI layout guidelines
    (tight input cap loop, short SW trace, EP thermal via array)
    - Passive silkscreen labels moved to F.Fab (fix_passive_layers.py)
    - Added spice/*.dat to .gitignore
2026-03-13 Allow 0.2mm traces on power/GND nets for tight IC pads
    Custom DRC rules override the net class track_width minimums
    (GND: 0.5mm, Power_24V: 3mm, Power_3V3: 0.5mm) to allow 0.2mm
    in tight spots like VSON-10 and SOT-23 pads. Router still defaults
    to the net class width — select 0.2mm manually when needed.
2026-03-13 Layout progress: buck routing, B.Cu GND pour, RS-485 started
    - Buck section fully routed (SW 0.3mm, EN via In3.Cu, output caps)
    - B.Cu GND copper pour under buck for thermal/shielding
    - U2 silkscreen labels moved to F.Fab
    - RS-485 section component placement in progress
2026-03-13 Relax silkscreen clearance to 0.075mm (JLCPCB min is 0.05mm)
    Reduces false DRC warnings from standard library footprints whose
    silkscreen outlines are close to their own pads.
2026-03-14 Layout progress: MCU neighborhood (decoupling, crystal, VBAT, voltage monitor, NRST)
2026-03-14 Layout progress: heater section condensed, analog section orphans reorganized
2026-03-18 Layout progress: analog section (muxes, RC filters, TVS, ADC), heater subsection wiring
2026-03-18 Shrink all vias to 0.5mm/0.3mm for JLCPCB POFV filling compliance
    JLCPCB requires vias ≤0.5mm diameter for epoxy fill + copper plating.
    Updated 367 existing vias (365×0.6mm + 2×0.8mm) and all netclass defaults.
2026-03-18 Layout progress: heater power path, tooling holes, board sizing exploration
2026-03-19 Layout progress: board resize to 100x65mm, connector alignment, heater power pours, MCU routing started
    Board shrunk from 100x100 to 100x65mm. Left-edge connectors aligned to X=105.
    Copper pours for V24_RAW and GND in heater area. Q1 thermal via array.
    Zone outlines updated to match new board edge. Mounting/tooling holes repositioned.
2026-03-19 Fix ADS1115 ALERT pull-up: connect reference.hv to V3V3
    The registry TI_ADS1115 module leaves alert_ready.reference.hv floating,
    causing an orphan "hv" net. Pull-up resistor now correctly connects to 3.3V.
2026-03-19 Layout progress: MCU pin routing, atopile rebuild with ALERT fix, re-add mounting/tooling holes
    Post-rebuild: passive silkscreen fix applied, mounting holes (4x M3) and
    tooling holes (3x 1.152mm NPTH) re-inserted at aligned positions.
2026-03-19 Fix ADS1115 I2C pull-up reference: connect sda/scl reference.hv to V3V3
    Same bug as ALERT pull-up — registry module leaves i2c reference.hv floating.
    Post-build: passive silkscreen fix, mounting/tooling holes re-added.
2026-03-19 Layout progress: routing complete, test pads added, silkscreen positioning, DRC cleanup
    All MCU pins routed. 8 through-hole test pads (V3V3, GND, V24_RAW, GATE,
    PGOOD, NRST, PNP_COLL, EXC). Silkscreen labels repositioned for readability.
    Annular ring violations fixed. U13 NC pads excluded from DRC.
2026-03-20 Add board art and silkscreen decorations
2026-03-20 Add more logos and finalize board art
2026-03-20 Add detailed specs: scan rates, board stats, per-unit cost breakdown
2026-03-20 Add comparison section: cost, battery life, and open platform advantages vs commercial
2026-03-20 Fix CR2032 battery holder pin polarity and R19 layout clearance
    Pin 1 (rounded pad) is negative (battery case/bottom), pin 2 (clip pad)
    is positive (battery top). Imported footprint had them swapped.
    R19 moved to clear diode body per JLCPCB review.
2026-05-01 Polish repo for shipped sap flux board
2026-06-05 Add 3D-printed enclosure generator and logo source art
    Parametric Blender (bpy) generator for a two-part transparent-PETG enclosure
    (base + drop-on Pi-style lid) for the assembled sap-flux board. Flush walls;
    terminals get a lid port (screws up) plus a left-wall notch (wires exit side);
    access windows for fuse/Q1/CR2032/60-pin/test-pads; vent grid; M3 corner screws.
    Rounded windows are subtracted as individual convex sub-solids (rrect_parts) so
    the EXACT boolean can't partially-skip a self-intersecting joined cutter -- that
    bug had left the Q1 window center un-cut. Logo relief disabled for now (the SVG
    fill+offset pipeline explodes into garbage islands); revisit later.
    .gitignore excludes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
2026-06-05 Add enclosure review and diagnostic tooling
    - plan_view.py: top-down overlay of lid windows on real component keep-outs.
    - render_views.py: auto-framed ORTHO renders (iso/left/lid-top/board-top); the
    bbox-projection framing fixes the camera that once left the left view blank.
    - diag_lid.py: raycast-grid ASCII map of a lid region to prove a window cut
    (this is what caught the Q1 boolean bug).
    - logo_test.py: fast logo-only harness for the deferred SVG->relief work.
2026-06-05 Add translucent exploded-view render script
    EEVEE render of base+board+lid exploded along Z, with the base and lid in a
    see-through blue alpha-blend 'PETG' material (Fresnel-driven edge opacity so the
    shells read as real translucent plastic) and the imported PCB recolored green.
    Board is floated above the base walls so the translucent front wall doesn't
    tint it. Tunable params (tint, alpha, rise, background) at the top.
2026-06-06 Enclosure: second-print revisions (orientation, nut trap, merged window)
    Fixes from the first print's feedback, all in the Blender generator:
    - Mirror fix (root cause): import_board used scale.y=-f, a REFLECTION not a
    rotation, so the board -- and every cut written in the by=Yk-85 frame -- came
    out mirrored along the terminal axis. Now scale=(f,f,f) + location.y=
    BOARD_H+85 (true orientation, silkscreen reads forward); MIRROR_BOARD_BY /
    _mirror_cut mirror every asymmetric lid window/port AND base wire-notch to match.
    - Nut trap: machine screws can't bite bare PETG, so each base post gets a bottom
    hex pocket capturing a press-fit M3 nut (M3x16 screw + washer -> ~3-thread
    steel en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
2026-06-06 napkin: Blender bmesh boolean + KiCad glb import gotchas
    - bmesh box cutters need recalc_face_normals or the EXACT boolean silently no-ops.
    - glTF importer respects scene unit scale (don't hard-code a x1000 m->mm scale).
    - KiCad glb Y-negation: correct it with a POSITIVE scale + position reflection,
    NOT scaleY<0 -- a negative single-axis scale is a reflection that mirrors the
    board and flips silkscreen backwards (the first-print mirror bug).
2026-06-22 Checkpoint v0.2 board bringup state
2026-06-22 Own mechanical footprints in Atopile
2026-06-22 Increase buck PFM current limit
2026-06-24 Add XFCN fuse footprint library
2026-06-25 Checkpoint idle-power board edits
2026-06-25 Propagate idle-power resistor picks to layout
2026-06-25 Reduce RS485 boot pulldown current
2026-06-25 Checkpoint manual silkscreen layout edits
2026-06-25 Move front logo polygons back to silkscreen
2026-06-26 Preserve v0.2 layout silkscreen edits
2026-06-26 Propagate v0.2 source fixes to board
2026-06-26 Restore KiCad 10 board syntax
2026-06-26 Substitute stocked resistors in v0.2 BOM
2026-07-11 Update enclosure for v0.2 board (rev 7)
    - Fuse window moved/resized for the new ATO blade-fuse holder (F1,
    XF-508P-B-B at bx8.4-15.2 by0.75-17); merges with the power port.
    - Q1 heatsink window recentred (Q1 moved to bx12.3-19.0 by35.5-44.4).
    - Terminal lid ports deepened to bx18: KF2EDGK plug tops are 15.7mm
    deep and overhang ~8.7mm inboard of the header; also widened in y
    up to the corner-pillar limits.
    - Zip-tie strap loops (2 per bx end wall): open-bottom staple tunnels
    flush with the back face, print flat with no supports; one tie per
    end wraps the trunk with the box long-axis vertical.
    - verify_holes() extended with tunnel/roof/leg ray checks.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
2026-07-11 Replace zip-tie staple loops with trapezoidal tabs
    Per user sketch: one trapezoidal flange per bx end wall (40->24mm
    taper, 15mm out, 4mm thick, flush with the back so it prints flat),
    with an 8mm circular tie hole. Removes the four staple arms.
2026-07-11 Extend fuse window toward the buck area
    The blade fuse crowds the power plug, so it gets leaned toward the
    buck side to coexist; window y1 26 (was 20) gives the tilted fuse
    top ~6mm of room and merges the window with the heater port opening
    (an intermediate y1 would leave an unprintable lid sliver).
2026-08-24 Add field-enclosure mounts for the QILIPSU box
    Two printed parts that bolt to the box's 5mm-pitch perforated mounting
    plate:
    - back_bracket + 2x peg_cap: carries the logic-board enclosure by its two
    Ø8 zip-tie tabs (121.0mm centres). The locating spigot lives on the cap
    rather than the bracket so the bracket's front face stays flat and prints
    with no supports; the cap head clamps the tab and threads into an M3 nut
    captured in the bracket.
    - battery_tray: 90-degree L that cups a 94.5x65.5x150.5mm pack standing on
    end and reaches 80mm up the plate. Closed-duct back panel for stiffness,
    driver access through the inner skin.
    Every screw pattern is an integer multiple of the 5mm gr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
2026-08-24 Simplify the battery tray to an open-bottom rim
    The pack stands on the enclosure floor, so the tray carries no load - the
    closed-duct back panel, the 3mm floor slab and the 30mm cup were all doing
    work nothing asked for. Replaced with an open-bottom rim plus two straps:
    - no floor to print (and it drains)
    - back is a single wall, not two skins with a 7mm cavity and side webs
    - 118.5 -> 32.9 cm3, bbox 102x89x80 -> 102x77x57
    - every surface is a vertical extrusion from the bed; the only bridges left
    are the 3.4mm slots and 6.6mm counterbores. Finger notch now cuts DOWN
    from the front wall's top edge instead of being a 28mm bridged hole.
    - 3mm lead-in chamfer at the rim's top inside edge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
2026-10-24 Add sap-flux-protocol wire protocol crate
    no_std COBS + CRC-32 framed protocol v1 shared by the STM32 firmware and
    host tools.
2026-10-24 Add sap-flux-monitor macOS desktop monitor
    Live thermistor plots, capture logging, and gated heater controls over
    the half-duplex RS-485 link, plus a built-in simulator.
2026-10-24 Kick TPL5010 and smoke-test muxes in board_test
2026-10-24 Add heater_monitor and bench monitor firmware bins
    heater_monitor speaks protocol v1 over RS-485 and optionally J6 LPUART2,
    driving the sap-flux-core pulse state machine. Also adds live, thermistor
    and RGB burn-in bench binaries.
2026-10-24 Add sap-flux probe drill guides
2026-10-24 Draft field gateway design: link, schedule lease, time, power
2026-10-24 Add pulse-trace compression study
    Lossless predictor+Rice, decimation, log-time spline and model-parameter
    tiers measured on the Aug 24 soaked-4x4 run, with flash and LTE-M budgets.
2026-10-24 Add Feather power latch, LiFePO4 and battery-life notes to design
2026-10-24 Add per-channel pulse representation figure
    Raw, 2 Hz bins, 12-knot log-time spline and model fit per channel and per
    pair difference, with smoothed residuals against the raw noise band.
2026-10-24 Correct design to one board with two probes; add measured clock drift
2026-10-24 Fix remaining two-board references in field design
2026-10-24 Add field protocol contract for board, gateway and server
2026-10-24 Record decision: board pulses autonomously without the gateway
2026-10-24 Add sapflux-uplink: no_std UDP datagram codec for gateway and server
    HMAC-SHA256/64 datagrams per docs/field-protocol.md section 2: CheckIn,
    CheckInReply, WindowPart, WindowAck, Event, EventAck, plus the 20-byte
    Schedule with the board's SetSchedule limits and schedule_crc. Golden
    vectors were computed independently with Python's hmac/struct. Builds
    for thumbv8m.main-none-eabihf so the nRF9160 gateway can share it.
2026-10-24 Add field-mode messages to sap-flux-protocol
    Implements docs/field-protocol.md section 1 on top of protocol v1:
    SetSchedule 0x07, GetWindow 0x08, AckWindow 0x09, GetFieldStatus 0x0A,
    Sample12 0x15, WindowInfo 0x16, WindowChunk 0x17, FieldStatus 0x18 and
    Ack result NOT_FOUND 0x04, plus window/flag/schedule constants.
    New field module: Schedule 20-byte encoding, schedule_crc, limit
    validation, window chunk math and the 16x-scaled i16 bin value codec
    with the -32768 missing sentinel. encode_frame emits the un-stuffed
    frame bytes the gateway forwards. Golden vectors in
    tests/vectors/field_v1.txt, cross-checked with an independent Python
    encoder.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
2026-10-24 Decode Sample12 and FieldStatus in sap-flux-monitor
    Normalizes Sample and Sample12 into a 12-channel SampleData so the
    pipeline, logger and UI handle both. samples.csv gains channel_count
    and probe-2 columns p2t1..p2t6 (empty for 6-channel frames); existing
    column names are unchanged. FieldStatus is shown in the Board panel
    and logged; WindowInfo/WindowChunk are logged as events. Probe-2
    controls appear after the first Sample12. The simulator now streams
    Sample12 with two probes.
2026-10-24 Latch NRF_PS_EN (P0.31) high in the diagnostic
    On battery the Feather's TPS63031 turns off unless P0.31 is driven high.
    USB power hid this on the bench.
2026-10-24 Ignore new field-mode protocol messages in bench bins
    The protocol crate gained SetSchedule/GetWindow/AckWindow/GetFieldStatus
    and the field board-to-host messages, which made the exhaustive Message
    matches in heater_monitor and live_monitor fail to compile.
2026-10-24 Clock the embassy time base from the LSE crystal via LPTIM1
    Replace the TIM2/HSI16 time driver with an LPTIM1 driver on the
    32.768 kHz LSE at tick-hz-32_768, so sample scheduling and monotonic_us
    are crystal-locked instead of drifting with HSI16 (-279/-433 ppm measured,
    up to ~1 % over temperature).
    embassy-stm32 0.6's time-driver-lptim1 does not compile for STM32G0
    (no rcc::Lptimsel), G0 RCC reports lse: None so its kernel-clock lookup
    would panic, and it reads LPTIM_CNT once. The new driver in
    src/timebase.rs selects LSE in RCC_CCIPR itself, double-reads CNT,
    extends the 16-bit counter from deltas in a critical section (ARRM
    interrupt every 2 s keeps it monotonic), sets IER only while dis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
2026-10-24 Reuse sap-flux-protocol Schedule in sapflux-uplink
    The protocol crate now exports Schedule, its limit checks and
    schedule_crc. Re-export them instead of keeping a second copy, and add
    validate_schedule() with the board's 600 s production cooldown.
2026-10-24 Generate gateway server/key constants from a gitignored config
    build.rs reads gateway.local.toml (or SAPFLUX_GATEWAY_CONFIG), falling
    back to the committed example with a warning, and emits SERVER_IP,
    SERVER_PORT, DEVICE_ID_OVERRIDE, KEY and IS_EXAMPLE.
2026-10-24 Add sap-flux-field bench CLI for board field mode
    Host CLI that speaks the field-protocol commands over J6 or RS-485:
    query, status, set-schedule, set-rtc (offset report), get-window
    (chunked download, CRC verify, CSV of 13 raw-count channels plus the
    uplink byte string) and ack-window. Each command sends a 0x00 wake
    byte, waits >=10 ms, and retries timeouts up to 3 times with the same
    nonce. Tested against a fake board and over a pty pair.
2026-10-24 Add sapflux-server crate: board frame and window decoding
    Parses v1 board frames (Hello, Status, FieldStatus, WindowInfo) via
    sap-flux-protocol, verifies reassembled science windows, decodes bins to
    raw counts and thermistor temperatures, writes CSV/JSON, and includes a
    reference binner that turns monitor capture frames into window bytes.
2026-10-24 Add sapflux-server UDP ingest, SQLite store and admin API
    tokio UDP ingest for the gateway datagram protocol (HMAC check, per-boot
    replay protection, check-in time sync and config push, window part
    reassembly with ack bitmaps, events). SQLite (WAL) holds devices,
    config history, check-ins, events and windows; each completed window is
    also written as .bin/.csv/.json. axum admin API on a separate,
    localhost/tailnet-only port. Example config with placeholder key.
2026-10-24 Add sapflux admin CLI
    `sapflux off|on <device>` is the remote heater kill switch; also status,
    schedule, bump, reboot-gateway, windows, export, events, history and
    keygen (prints matching server and gateway key snippets). Works directly
    on the server's SQLite database.
2026-10-24 Add Rust gateway simulator and end-to-end tests
    sim.rs models the board (Hello/Status/FieldStatus, schedule push) and the
    gateway (check-in time sync, window part upload with resend from the ack
    bitmap, events). sapflux-gateway-sim drives a real server. Integration
    tests run the full UDP + API cycle: time sync, kill switch, replay/MAC
    rejection, lost parts, corrupt windows, run_id generations, reboot
    requests, a window built from the real bench capture, and the protocol
    crate's golden vectors.
2026-10-24 Add sapflux-server deploy kit for a Hetzner Ubuntu 24.04 VPS
    Static musl build via cargo-zigbuild (x86_64 or aarch64) packed into a
    bundle; install.sh creates the service user, config/data dirs, systemd
    units and ufw rules (SSH + 47800/udp public, tailscale0 trusted).
    A systemd timer replicates a sqlite3 .backup snapshot and the window
    files to acacia over Tailscale with rsync. README covers VPS creation,
    Tailscale join, keys, gateway config and day-to-day CLI use.
2026-10-24 Pin down bin clamp, ack bitmap order and retry seq in field protocol
2026-10-24 Add the field gateway application (board link, LTE-M/UDP, time sync)
    Default binary for the nRF9160 Feather: latches P0.31, polls the board
    over the J6 UART (wake byte, retries), checks in with the server using
    sapflux-uplink (HMAC, per-boot boot_id/seq), syncs time with four
    timestamps, pushes schedule/RTC, forwards pending windows, and sleeps
    until the next check-in or post-window wake. WDT supervision with a
    panic record, PSM-requested LTE-M only, log UART released between
    cycles. The diagnostic stays available as the diag binary.
2026-10-24 Add autonomous pulse planner to sap-flux-core
    The planner turns a field-protocol Schedule into the same machine calls a
    host makes (start_baseline, arm, request_fire, abort), one action per
    poll, so the persisted lockout, cooldown, pulse limits and health checks
    all still apply. Slots follow (t - phase) mod interval on the RTC, or a
    monotonic anchor + k*interval while the RTC is invalid. Missed slots are
    skipped, unhealthy runs abort after a 3 s grace, and disabling or a lost
    lease aborts only runs that have not fired.
    BaselineRequest gains require_rtc so a scheduled TIME_INVALID run can
    arm without a valid RTC; host runs keep requiring it.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
2026-10-24 Add pulse-window binning and RAM window store to sap-flux-core
    Frames are binned on the monotonic clock and each closed bin is encoded
    straight into its slot (13 x i16, relative to the first bin's rounded
    mean, sentinel for no valid reads), so a window costs its wire size.
    The store keeps SLOTS windows, overwrites the oldest undelivered one when
    full (counted as dropped), truncates windows longer than a slot, serves
    WindowInfo/WindowChunk by run id (0 = oldest) and frees on AckWindow,
    answering retried acks as OK. All-zero when empty so it sits in .bss.
2026-10-24 Add capture survey, noise study and encoder harness for compression research
2026-10-24 Add EEPROM record layout and RTC trim learning to sap-flux-core
    Records (schedule at 0x0000, trim at 0x0020, boot count at 0x0040) are
    magic + payload + CRC-32 inside one 32-byte page, well clear of the
    heater lockout at 0x0FC0. The trim module converts ppb to RTC_CALR
    (CALP/CALM, checked against Python reference values) and learns drift
    from SetRtc steps: anchor, accumulate, and after >= 6 h move the trim by
    half the residual, clamped to +/-200 ppm, ignoring implausible residuals
    and restarting on large steps or an invalid RTC.
2026-10-24 Match the server: latest-ack bitmap, resend all on failed reassembly, port 47800
    The server's WindowAck bitmap is cumulative and is cleared when the
    reassembled window fails verification, so take the latest bitmap instead
    of OR-ing, and resend every part when all are stored but not complete.
    Gate board steps on a live board link.
2026-10-24 Add opt-in latch-sleep via the PCF85063A alarm (unverified)
    Behind the latch-sleep feature: set a relative RTC time and alarm, drop
    NRF_PS_EN, and fall back to a timer sleep if power stays on. Whether the
    alarm re-enables the regulator on v1-v3 boards is not verified.
2026-10-24 Sample both probes at 25 Hz and stream Sample12 in heater_monitor
    Each frame now reads 12 thermistors (probe 1 on mux A, probe 2 on mux B)
    plus excitation through one named THERMISTOR_MUX_MAP; probe 2 assumes an
    identical cable on J2 block B (therm_17..22 -> mux B Y1,Y0,Y3,Y2,Y5,Y4)
    and is marked as needing bench confirmation. Frames run on a fixed 40 ms
    grid (24.3 ms acquisition per the Python budget) and stream as Sample12,
    replacing the 6-channel Sample (the monitor decodes both and would
    double-log). The RS-485 command window is now the last frame of each
    1 s cycle, followed by one silent frame; Status moves mid-cycle so it
    never closes the window.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
2026-10-24 Run the internal watchdog in heater_monitor
    The design lists IWDG as a heater safety layer but heater_monitor never
    started it. Start it at boot with a 4 s timeout and pet it once per frame
    and in the command poll loop. The longest deliberate stall is a SetRtc
    wait (<= 1 s); the TPL5010 external watchdog is serviced as before.
2026-10-24 Run the stored pulse schedule autonomously in heater_monitor
    SetSchedule validates against the field limits (with the build's real
    cooldown), persists the 20 schedule bytes in EEPROM at 0x0000 (magic +
    CRC, written only when a non-lease field changes) and keeps the lease in
    RAM plus TAMP BKP2. A blank or bad record means the disabled factory
    default. A disable always takes effect in RAM even if the EEPROM write
    fails; anything else is applied only once persisted.
    Each frame the planner's actions go through the same machine calls as
    host commands, and FirePulse and the scheduler now share one
    persist-lockout-then-one-pulse function. GetFieldStatus and field-mode
    Query report FieldStatus. A b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
2026-10-24 Record scheduled runs into the RAM window store in heater_monitor
    Each scheduled run opens a window at baseline start, bins every frame
    (12 thermistors + excitation) into 500 ms bins, notes the heater-on time,
    and closes when the run leaves Baseline/Armed/Pulsing/Recovery. A fault
    sets HEATER_FAULT. GetWindow answers WindowInfo/WindowChunk or
    Ack NOT_FOUND; AckWindow frees the slot. FieldStatus reports the store.
    Four 1000-bin slots take 104 000 B of .bss, leaving 39 KB for the stack.
2026-10-24 Make the field link reply-only with PA14 released between replies
    With the PA6 strap low the board now uses LPUART2 alone: no Hello,
    Status or Sample12 is sent unsolicited, PA14 stays analog except while a
    reply burst is on the wire (leading 0x00 after a 200 us idle-high
    settle), commands that arrive while the heater is on wait in a 512 B RX
    ring until the pulse ends, and the SP3485 is held in shutdown with
    USART2 left unconfigured. Bench mode keeps v1 RS-485 streaming.
2026-10-24 Bump heater_monitor to firmware 0.2.0 (dev build 0.2.32)
2026-10-24 Add SFK1 reference encoder/decoder, anomaly and idle-summary experiments
    Bit-exact bitstream with round-trip test and fixed-point emulation;
    250 B/pulse for 12 thermistors at <=3.4% RMSE cost on V/HRM.
2026-10-24 Pulse TPL5010 DONE on a 1 s cadence instead of polling WAKE
    WAKE is a 20 ms pulse and was only polled between ADC acquisitions,
    which now take ~24 ms at 12 channels. A missed WAKE makes the TPL5010
    reset the MCU and fire the SCR heater latch until a power cycle.
2026-10-24 Give the board's SetRtc reply 2 s in the gateway
    The board waits for the next second boundary before acknowledging, so
    its reply can take ~1.25 s; the old 1.3 s timeout left almost no margin.
2026-10-24 Treat AckWindow NOT_FOUND as delivered in the gateway
    A re-ack after a board reset no longer aborts the rest of the cycle's
    window transfers.
2026-10-24 Step a valid board RTC only from a sync with RTT <= 1 s
    Uplink/downlink asymmetry biases the four-timestamp offset by up to
    RTT/2; looser syncs still set the gateway clock and an invalid board
    RTC, but no longer nudge a valid one (or its learned trim).
2026-10-24 Reject schedules whose window exceeds the board's 1000-bin slot
    The board silently truncated such windows; validate() (used by the
    board, server and CLI) now rejects them as WindowTooLong.
2026-10-24 Skip late WindowChunk replies inside the board link collector
    Chunks carry no nonce, so a late reply to an earlier chunk request used
    to end the attempt and burn a retry; the collector now ignores chunks
    for any other (run_id, chunk) and keeps waiting.
2026-10-24 Abandon a window that fails verification three times in a row
    A window whose header is inconsistent or whose data_crc32 never matches
    used to stay at the head of the board's queue forever, blocking every
    window behind it. After BAD_WINDOW_LIMIT consecutive failures the
    gateway now frees it with AckWindow and logs EVENT_WINDOW_DROPPED.
2026-10-24 Add a W25Q256 flash driver and boot JEDEC check to heater_monitor
    sap-flux-core gains flash.rs: the 24 MiB raw / 8 MiB window layout, ring
    address math, a Nor trait and a Flash wrapper that tracks the one
    outstanding program or erase against datasheet-maximum deadlines, so a
    dead chip fails instead of hanging the loop. Host tests use a RAM fake.
    sap-flux-blinky gains w25q.rs (SPI2 at 4 MHz, 4-byte opcodes 0x13/0x12/
    0x21). heater_monitor reads the JEDEC ID at boot, waits (bounded) for any
    interrupted erase, reports flash_ok in FieldStatus and sends an
    ErrorReport (0x0100) on the bench link when the ID is wrong.
2026-10-24 Add a one-figure Implexx/Campbell vs SFK1 comparison
    Plots the real Aug 24 pulse twice: what an Implexx probe and Campbell
    logger keep (pre-pulse T, tMax, HRM window values) and the full curve
    decoded from the SFK1 record, at about 20 B per thermistor each.
2026-10-24 Redraw the Implexx/Campbell vs SFK1 figure as a flow with byte packing
    Traces one real pulse from excitation and thermistor ADC counts to a
    temperature rise, forks it into the Implexx/Campbell and SFK1 paths,
    and ends in a byte-packing diagram of raw samples, SFK1, SapFlowAll
    and the ShortCut table for a two-probe box.
2026-10-24 Size the byte formats by area in the SFK1 comparison figure
    Section 4 now draws raw, lossless, SFK1, SapFlowAll and ShortCut as
    squares with area proportional to bytes at one scale, with connectors
    to zoomed field layouts of each record.
2026-10-24 Log every run's raw 25 Hz frames to flash and add GetRaw retrieval
    heater_monitor appends each frame from Baseline through Recovery (scheduled
    or host-commanded) to an append-only ring in the lower 24 MiB of the
    W25Q256. Frames pack into CRC-sealed 256 B blocks (run_id, seq,
    block_in_run; delta-coded, up to 12 frames per page). Runs start on a sector
    boundary, so the boot scan reads only 16 B per sector to find the head, the
    oldest sector and every run start. Two sectors stay erased ahead of the
    head; erases only start while the heater is off, programs are one page per
    wait-loop pass, and a block that finds the two-deep queue full is dropped
    and counted. FieldStatus flash_used_kib reports th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
2026-10-24 Persist completed windows to 256 flash slots and serve them from there
    A finished window stays in the RAM store while heater_monitor writes it to
    the next 32 KiB slot in the upper 8 MiB of the W25Q256: erase 8 sectors,
    program the data pages, program the header page (WindowInfo frame + seq +
    CRC) last as the commit, then read everything back against the RAM copy.
    Only a verified window is released from RAM, so a reset never loses an
    undelivered window and none is ever counted twice. Boot reads the 256
    header pages and serves undelivered windows from flash.
    AckWindow marks the slot delivered by programming its marker byte
    0xFF -> 0x00, deferred to the storage service so the command never wai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
2026-10-24 Report an EEPROM fault in FieldStatus and retry the boot lockout read
    schedule_flags bit 6 (FIELD_STATUS_EEPROM_FAULT) is set while fault_code is
    FAULT_PERSISTENCE, i.e. the scheduler is holding because the heater lockout
    record could not be read or written. Before this the field only saw a
    schedule that silently never pulsed.
    At boot the lockout read is tried 3 times, 10 ms apart, so one I2C glitch
    or an EEPROM still in its write cycle does not hold the schedule until the
    next power cycle. A read that still fails keeps the fail-safe (locked out).
    Docs section 1, the protocol constant, the field CLI status flags and the
    server's schedule flag names gain the new bit.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
2026-10-24 Bump heater_monitor to 0.3.0 and add flash bench checks to the README
    Firmware 0.3.0 (supervised bench build 0.3.32) carries the W25Q256 raw frame
    log, flash-persisted windows and the FieldStatus EEPROM-fault flag. The
    README describes the flash layout and capacity and adds bench steps for the
    JEDEC check, get-raw, windows surviving a reset and the eeprom_fault flag.
2026-10-24 Reject torn raw-log prefixes when choosing where to resume
    A program cut by power loss leaves bits at 1, which can inflate a sector's
    unprotected seq and make the boot scan resume over newer data. A prefix now
    counts only if its seq matches its ring position, and the chosen newest
    sector's first block must pass its CRC or the scan repeats without it.
2026-10-24 Save windows into free slots before dropping an undelivered one
    The window ring always took the next slot, so one window left pending
    behind 255 delivered ones was overwritten. A save now takes the next empty
    or delivered slot, and drops the oldest pending window only when all 256
    hold undelivered ones, as documented.
2026-10-24 Leave 1 s of slack when checking a schedule fits 1000 bins
    Recovery starts when the board sees the pulse end, so a real window runs a
    little past its nominal span. A schedule of exactly 1000 nominal bins then
    needed 1001 and lost its tail to truncation; validation now adds 1 s.
2026-10-24 Answer a retried AckWindow without applying it again
    A lost Ack reply makes the host resend AckWindow with the same nonce. With
    two windows sharing a run id, the resend retired the second, never
    uploaded copy. The board now remembers the last applied (nonce, run_id)
    and only answers a repeat, as it already does for SetRtc.
2026-10-25 Add an integer firmware mode to the SFK1 reference encoder
    encode(w, fixed_point="firmware") mirrors, operation for operation, the
    integer arithmetic an MCU encoder can run: Q24 ratios from a 13-frame
    excitation boxcar, Q3 baseline bins, a closed-form line fit, an integer
    log2 B-spline basis, and a Q36 projection matrix. Missing post-onset
    frames are interpolated within 6 frames. The existing modes and their
    outputs are unchanged.
    --firmware reruns the corpus: 0 round-trip mismatches over 98 windows,
    and the RMSE ratio is within 0.014 (k12) / 0.016 (k16) of float SFK1.
    That is inside the spread a 1-2 count change of E_ref causes on its own.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
2026-10-25 Add the sfk1 crate: a no_std SFK1 encoder and decoder
    Encoder<N, P> is the streaming integer encoder. It needs no alloc, has
    no panic paths and no unsafe, and the board aliases are Encoder12 and
    Encoder16. It is generic over the thermistor count N and a public
    Profile trait, which carries the sampling grid and the trained tables.
    East30K12 and East30K16 are the board profiles.
    N = 12 East30 records keep the 6-byte 0x53/0x54 header. Every other
    record uses an extended 0x5F header with a profile id, N and a
    ceil(N/8)-byte mask. Decoder<P> learns N from the record. With alloc,
    decode() returns owned, serde-ready channels.
    tools/generate.py writes src/tables.rs and custom profile tables from
    t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
2026-10-25 Check sfk1 against golden vectors from the Python reference
    tools/generate.py writes the vectors: 3 real captures with missing frames
    and 2 synthetic windows, 605 kB in all. Each holds the nominal-grid frames,
    the firmware-mode and float records for 12 and 16 knots, and the Python
    decoder's output.
    The Rust encoder reproduces all 10 firmware records byte for byte. The
    decoder recovers the same integers and matches the Python curves to
    5.8e-11 counts over 25,948 samples. Each record is refused by the other
    profile and by any truncation.
2026-10-25 Add an sfk1 example that encodes a real bench capture
    real_pulse reads a sap-flux-monitor session's samples.csv and places the
    frames on the 25 Hz grid, as fw_frames does. It then encodes with
    Encoder12 or Encoder16 and decodes the record again. The 24 Aug soaked
    pulse gives 109 B (1373x smaller than the raw frames). generate.py
    --check-record confirms the record is byte-identical to Python firmware
    mode.
2026-10-25 Keep the 25 Hz frame grid when a frame runs late
    After an overrun the loop restarted the grid from now, so every late frame
    slipped all later ones and the mean rate fell below 25 Hz. A late frame is
    now followed at once by the next, and only whole missed slots are skipped,
    keeping the exact grid SFK1 assumes.
2026-10-25 Give sfk1 profiles a frame period instead of an integer rate
    Profile::SAMPLE_RATE_HZ (u16) could not express grids below 1 Hz, which a
    large multiplexed array needs. FRAME_PERIOD_US (u32, default 40 000 = 25 Hz)
    replaces it; Profile::frame_time_s converts frames to seconds and gives
    bit-identical times for East30. The fingerprint hashes the period, so
    profile ids change (nothing is deployed). generate.py takes --period-us;
    probe48 tables regenerate unchanged.
2026-10-25 Let sfk1 decoders evaluate a channel at any time
    ChannelCoefs::curve() returns a Curve whose at(t) gives the reconstruction
    off the frame grid; Samples now iterates a Curve. This is what a
    multiplexed front end needs: each channel is sampled a fixed delta after
    its frame instant, which the record does not carry, so the decoder either
    relabels samples (t + delta) or resamples with curve.at(t - delta). The
    sample-timing rules are documented on Curve, and tests check that at()
    matches the samples on the grid and that shifting by a 0.5 s offset cuts
    the timing error from 2.7 to 0.24 counts.
2026-10-25 Describe sfk1 as a general heat-pulse format with East30 as a profile
2026-10-25 Add an anisotropic vector heat-pulse model for multi-needle layouts
    Moving finite-pulse line source with a 2x2 diffusivity tensor and a
    heat-velocity vector, Fisher information and a MAP whole-curve fit.
    check_model.py confirms it reduces to fit_4x4_pulse.finite_pulse_response
    in the 1-D limit and matches brute-force quadrature.
2026-10-25 Measure SFK1 table cost across thermistor geometries
    exp_geometry.py simulates a 2D moving finite line source at axial
    0.5-1.0 cm up/downstream, tangential and 45 deg diagonal positions with
    physical amplitudes, and compares coefficient bits under the shipped
    East30 tables, a shared union table set, per-class k-tables and
    per-class rotations. Per-spacing rotation + k-table classes save 13-51 B
    per 12-channel record away from 0.6 cm; k-tables alone recover about
    half. Reconstruction RMSE is identical across strategies, as expected
    for a rotation.
2026-10-25 Train custom sfk1 profiles at the probe's thermistor positions
    generate.py --profile now simulates its training pulses with the 2D moving
    finite line source of exp_geometry.py at the positions given by
    --positions (x along the flow, cm), with physical amplitude and priors
    set by --k-range, --v-range, --flow-angle-deg, --pulse-s, placement errors
    and --peak-counts (East30 defaults). SVD column signs are fixed so tables
    do not depend on the LAPACK build. --struct also emits the impl
    sfk1::Profile, and the command line is recorded in the file.
    Distance from the heater is what the tables need to match (research
    README section 11), so each spacing gets its own profile; no format
    change. tests/sp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
2026-10-25 Bundle an sfk1 profile for the offset East30 probes
    East30Offset is trained for thermistors 10 mm above the heater and 5 mm
    below (generate.py --positions='1,0 -0.5,0'), and sfk1::decode recognises
    it. On simulated 6-thermistor pulses it cuts the offset probe's mean
    record from 153 B to 122 B (148 B to 121 B when installed upside down,
    which decodes the same curve); classic 6 mm probes stay on East30K12
    (111 B vs 125 B), so the rule is one profile per probe type.
    generate.py gains --name and derives the usual traits on --struct output;
    the geometry tests move to tests/geometry_profiles.rs.
2026-10-25 Add needle blur, common-mode loss and dual-role needles to the vector model
    Finite needle radius enters as a kernel covariance offset, an exp(-lambda tau)
    loss term covers the decay seen in real captures, and layouts can mark every
    needle as both heater and thermistor. New shadow-avoiding (Y3) and dual-role
    (dual2/3/4) layouts.
2026-10-25 Quantify 1-D heat-pulse bias from probe rotation in anisotropic wood
2026-10-25 Compute Cramer-Rao bounds on flow direction and speed by needle layout
2026-10-25 Show radial flow is visible only through heater end effects
2026-10-25 Define SFK1 windows and probe kinds in the field protocol
    SetSchedule flags bit 1 selects SFK1 windows and bits 2-5 give each probe
    port's kind (East30 6 mm or East30 offset 10/5 mm), which picks the SFK1
    profile. An SFK1 window's data is one length-prefixed record per probe,
    flagged in WindowInfo, with n_bins as its byte length.
2026-10-25 Encode field windows as SFK1 records, one per probe
    An Sfk1Window runs a 6-channel encoder per probe port with the profile its
    kind names (East30K12 or East30Offset), placing frames on the 40 ms grid by
    time. The window store hands SFK1 windows' frames to it instead of binning
    them, and finishing writes the length-prefixed records into the slot, so
    flash persistence and chunked download carry them unchanged.
2026-10-25 Record SFK1 windows on the board when the schedule asks for them
    The field firmware attaches an Sfk1Window to the window store and begins
    each window with the schedule's probe kinds when its SFK1 flag is set.
    sfk1 and sap-flux-core build at opt-level s: the encoders add 11 kB of
    text instead of 24 kB, leaving 17 kB of flash.
2026-10-25 Bound flow direction per needle with blur and loss in the model
2026-10-25 Show flow information is gain-limited unless heaters are reciprocal
    Single-heater layouts read the flow from amplitude ratios, which channel
    gains fully absorb; dual-role needles with known heater-energy ratios do not.
2026-10-25 Model needle blockage, wound and flow shadows with Darcy flow plus FD heat
    Each needle and wound is an impermeable disk in anisotropic Darcy flow; the
    heat pulse is simulated in that field and fitted with the analytic model.
2026-10-25 Keep the window store in .bss with SFK1 parameters off
    Option<Sfk1Params> put its None in a ProbeKind niche, a nonzero byte,
    which moved the 104 kB window store into .data and overflowed flash.
    Sfk1Params::OFF (all zero) marks a binned window instead.
2026-10-25 Decode SFK1 windows on the server
    Verify SFK1 window data by its byte length and entry structure, decode
    each probe's record with sfk1::decode and lay the curves out on the
    record frame grid in the 13-channel layout, so the CSV keeps the binned
    window's channel columns (one row per 40 ms frame) and temperatures.
    The JSON summary lists each record's profile, size and live channels.
2026-10-25 Configure SFK1 and each board's probes on the server
    Settings, [defaults], the API and `sapflux schedule` gain sfk1, probe1,
    probe2 (none, east30, east30_offset) and probeN_flipped. SFK1 and the
    probe kinds go to the board in the schedule flags; which way up a probe
    is stays on the server (new device_config column, added to existing
    databases) and is written into each stored window's JSON.
2026-10-25 Write up flow-vector identifiability, needle cost and recommendations
2026-10-25 Set and read SFK1 windows from the field CLI
    `schedule` gains --sfk1 and --probe1/--probe2 (none, east30,
    east30-offset) and handles ScheduleError::Sfk1, whose missing arm broke
    the build. A downloaded SFK1 window is checked entry by entry, its
    summary lists each probe's record, and its CSV has one row per 40 ms
    frame with the binned window's 13 channel columns.
2026-10-25 Simulate the lowercase-y needle layout and the drilling-drift tolerance
    Study A: Darcy + Crank-Nicolson FD (needle_cost physics, 0.9 mm heater, 21G
    sensors, wounds) for collinear, offset-pair and lowercase-y layouts over
    offset, Kp and +-20 deg installs, with fits and CRBs. The y at 3a fitted with
    flow along the grain and R pinned holds 0.76-0.87 of true speed across every
    case, against 0.50-0.79 for East30 and 0.66-0.86 for a collinear pair.
    Study B: 12 cm needles with tilted sensor holes as exact 2-D slices, the
    assumed day profile, and fit_pair (the repo's position-from-trace method)
    against naive, amplitude-spacing and structured joint line fits. With
    fit_pair the jig spec is 0.25 deg p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
2026-10-25 Bundle sfk1 profiles for fast sap flow: East30Wide and East30Extreme
    East30K12 reproduces the curve to about 70 cm/h and East30K16 to 100.
    East30Wide (20 knots, tables trained over -10..150 cm/h) holds to 150
    and East30Extreme (24 knots, -20..200 cm/h) to 200, both at t0 = 2 s, for
    about 276 and 302 B per typical 12-thermistor pulse. They use the
    extended header; K12 and K16 are unchanged. sfk1::decode recognises both.
    tests/flow_range.rs checks ids, round trips, decode dispatch and each
    profile's flow range on simulated pulses.
2026-10-25 Document how to choose an sfk1 profile by flow range
    README and crate docs get a table of the four East30 profiles: knots,
    t0, header, bytes per typical pulse, the flow range each reproduces and
    its error at 100/150/200 cm/h, plus the new profile ids and sizes.
2026-10-25 Add a mixture velocity prior to sfk1's generate.py
    --v-typical MEAN SD WEIGHT trains a WEIGHT share of the curves at
    N(MEAN, SD) cm/h and the rest uniform over --v-range, all clamped to
    it. Without the flag the random stream is unchanged, so existing
    tables regenerate byte for byte (checked on east30_offset.rs).
2026-10-25 Bundle a matrix of sfk1 presets with a catalog
    24 East30 presets: both geometries (East30 at +-0.6 cm, the offset probe
    at +1.0/-0.5 cm), 12/16/20/24 knots, and three training priors: slow
    (uniform -4..32 cm/h), mixed (85% N(5, 6) plus 15% uniform over the
    preset's range) and fast (uniform over the range). East30K12, East30K16
    and East30Offset are the slow cells of their rungs and are unchanged.
    The unreleased East30Wide and East30Extreme become East30K20Fast
    (retrained to -20..165) and East30K24Fast (same tables).
    One list drives sfk1::BUNDLED, a PresetInfo catalog with each preset's
    id, geometry, knots, t0, prior, accurate range and record sizes, and the
    decode() dispatch. tests/flow_rang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
2026-10-25 Document how to choose among the sfk1 presets
    README and crate docs get two tables, one per probe geometry, with rows
    for the fastest flow (knot count) and columns for how often flow is fast
    (training prior), each cell with the bytes per typical pulse and at the
    top of its range. Also the error past each range, how the ranges were
    measured, per-preset flash and RAM costs, and the current profile ids.
2026-10-25 Carry an SFK1 preset per probe in the schedule
    The schedule grows to 22 bytes with sfk1_presets: knots in bits 0-1,
    training prior in bits 2-3, code 0 the original 12-knot slow profile.
    SetSchedule is 34 B and the uplink CheckInReply 62 B. Presets parse and
    print as 12, 20-mixed, 24-fast.
2026-10-25 Link SFK1 presets that fit in flash and refuse the rest
    The board links East30 12, East30 20-mixed and East30 offset 12, leaving
    8.3 kB of flash. SetSchedule answers an unlinked preset with
    INVALID_PARAMETER, and a stored schedule naming one falls back to the
    factory default at boot.
2026-10-25 Configure SFK1 presets per probe on the server
    probe1_preset/probe2_preset in [defaults], the API and sapflux schedule,
    stored in a new device_config column and recorded with each window.
2026-10-25 Bump heater_monitor to 0.4.0 for the 22-byte schedule
2026-10-25 Remove the short-cooldown bench build
    heater_monitor now has one build, the production one with the 600 s
    cooldown and 60 s minimum recovery, for the bench and the field.
2026-10-27 Add Planner::next_start_ms so the board can sleep until a run
2026-10-27 Sleep in Stop 1 between runs on the field link
    The field board now measures only during a run and for 30 s before each
    scheduled baseline. In between, excitation, the muxes and the internal ADC
    are off, and the core sits in Stop 1 with the internal and SPI flash powered
    down. It wakes every 1.5 s for the watchdogs, the battery reading and the
    scheduler, or on the host's wake byte (EXTI on PA13), then stays awake for
    1 s after the last command. Bench (RS-485) streaming is unchanged.
2026-10-27 Sleep on RS-485 when no host is attached
    The bench link streamed forever, so a board on the RS-485 strap never
    slept. It now streams from boot and for 10 min after each host frame,
    then replies only and sleeps between runs like the field link. A falling
    edge on PA3 (EXTI line 3) wakes it from Stop, and DBG_STOP keeps SWD
    usable while it sleeps.
    The SP3485 has no shutdown mode, so the docs no longer claim a
    shutdown or polling mode for it.
2026-10-27 Wake the board and keep it attached from the monitor
    The board now stops streaming 10 min after the last host frame and
    sleeps. After 2 s of silence the monitor sends the 0x00 wake byte, waits
    15 ms and sends a Query (retried every 5 s). While the board streams it
    queues a keepalive Query once a minute, so an open monitor keeps the
    board attached. User commands still leave only in command windows.
