RileyLeff/sapflux_sensor/(notices)

Notices in the files:
elec/parts/CAZN_M8_P4A_GPL_M8_JD/CONN-TH_M8-P4A-GPL-M8-JD.STEP:
FILE_NAME ('CONN-TH_M8-P4A-GPL-M8-JD.STEP',
parts and their libraries:
CONN-TH_M8-P4A-GPL-M8-JD footprint
